bruinformula/mk11-DAQ-SMU/SMU V3/SMU.step

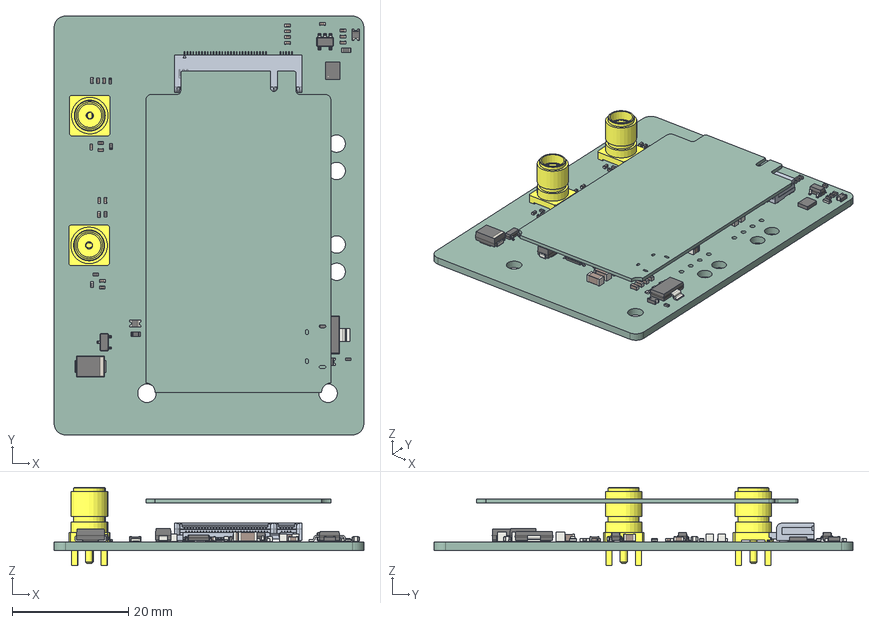
[picture p1: CAD file, 2026-05-11]
SMU V3/SMU.step
53.4 x 72.2 x 13.5 mm
SMA-J-P-H-ST-TH1 x 2
SOT-23-3
C_0402_1005Metric x 26
C_0805_2012Metric x 5
C_0603_1608Metric x 9
R_0603_1608Metric x 4
C_1206_3216Metric x 5
L_0402_1005Metric x 2
R_0402_1005Metric x 7
R_0805_2012Metric
D_0805_2012Metric x 5
D_SMA
SOT-23-5 x 3
c-1-2199119-5-c-3d
DU UC V1MINI - Krill_PCB
TI_SO-PowerPAD-8
D_SMB
LGA-14_3x2.5mm_P0.5mm_LayoutBorder3x4y
SOT-223
SMU V2_PCB
