bruinformula/mk11-DAQ-SMU/SPICE/power.asc

C1: cap; 0.01µ; V=10 Irms=0 Rser=0.0697 Lser=689p mfg="Würth Elektronik" pn="885012208008 WCAP-CSGP 1206" type="X7R"
C2: cap; 22µ; V=6.3 Irms=0 Rser=0.005 Lser=0 mfg="Murata" pn="GRM187R60J226ME15" type="X5R"
C3: cap; 22µ; V=6.3 Irms=0 Rser=0.005 Lser=0 mfg="Murata" pn="GRM187R60J226ME15" type="X5R"
C4: cap; 1.7p
D1: schottky; SS24
R1: res; 10k
R2: res; 3.3k
R3: res; {RLOAD}
R4: res; 180k
U1: TPS5430_TRANS
U2: CL31A107MQHNNN_Precise_DC0V_25degC_LT
U3: CL31A107MQHNNN_Precise_DC0V_25degC_LT
U4: CL31A107MQHNNN_Precise_DC0V_25degC_LT
U5: CL31A107MQHNNN_Precise_DC0V_25degC_LT
U6: CL31A107MQHNNN_Precise_DC0V_25degC_LT
U7: ETQP3M150KVN
V1: voltage; 12; Rser=.1
Named nets: 0, SW, Vsense, BOOT, VIN, VOUT, Vfb
.param RLOAD 200
.tran 0 30m 0 10u uic
.ac dec 10 1k 50Meg
.step dec param RLOAD 3 200 2
