bruinformula/mk11-DAQ-SMU/SMU V3/SMU V3.kicad_pcb

## KiCad design SMU V3/SMU V3.kicad_pcb (2026-05-11)

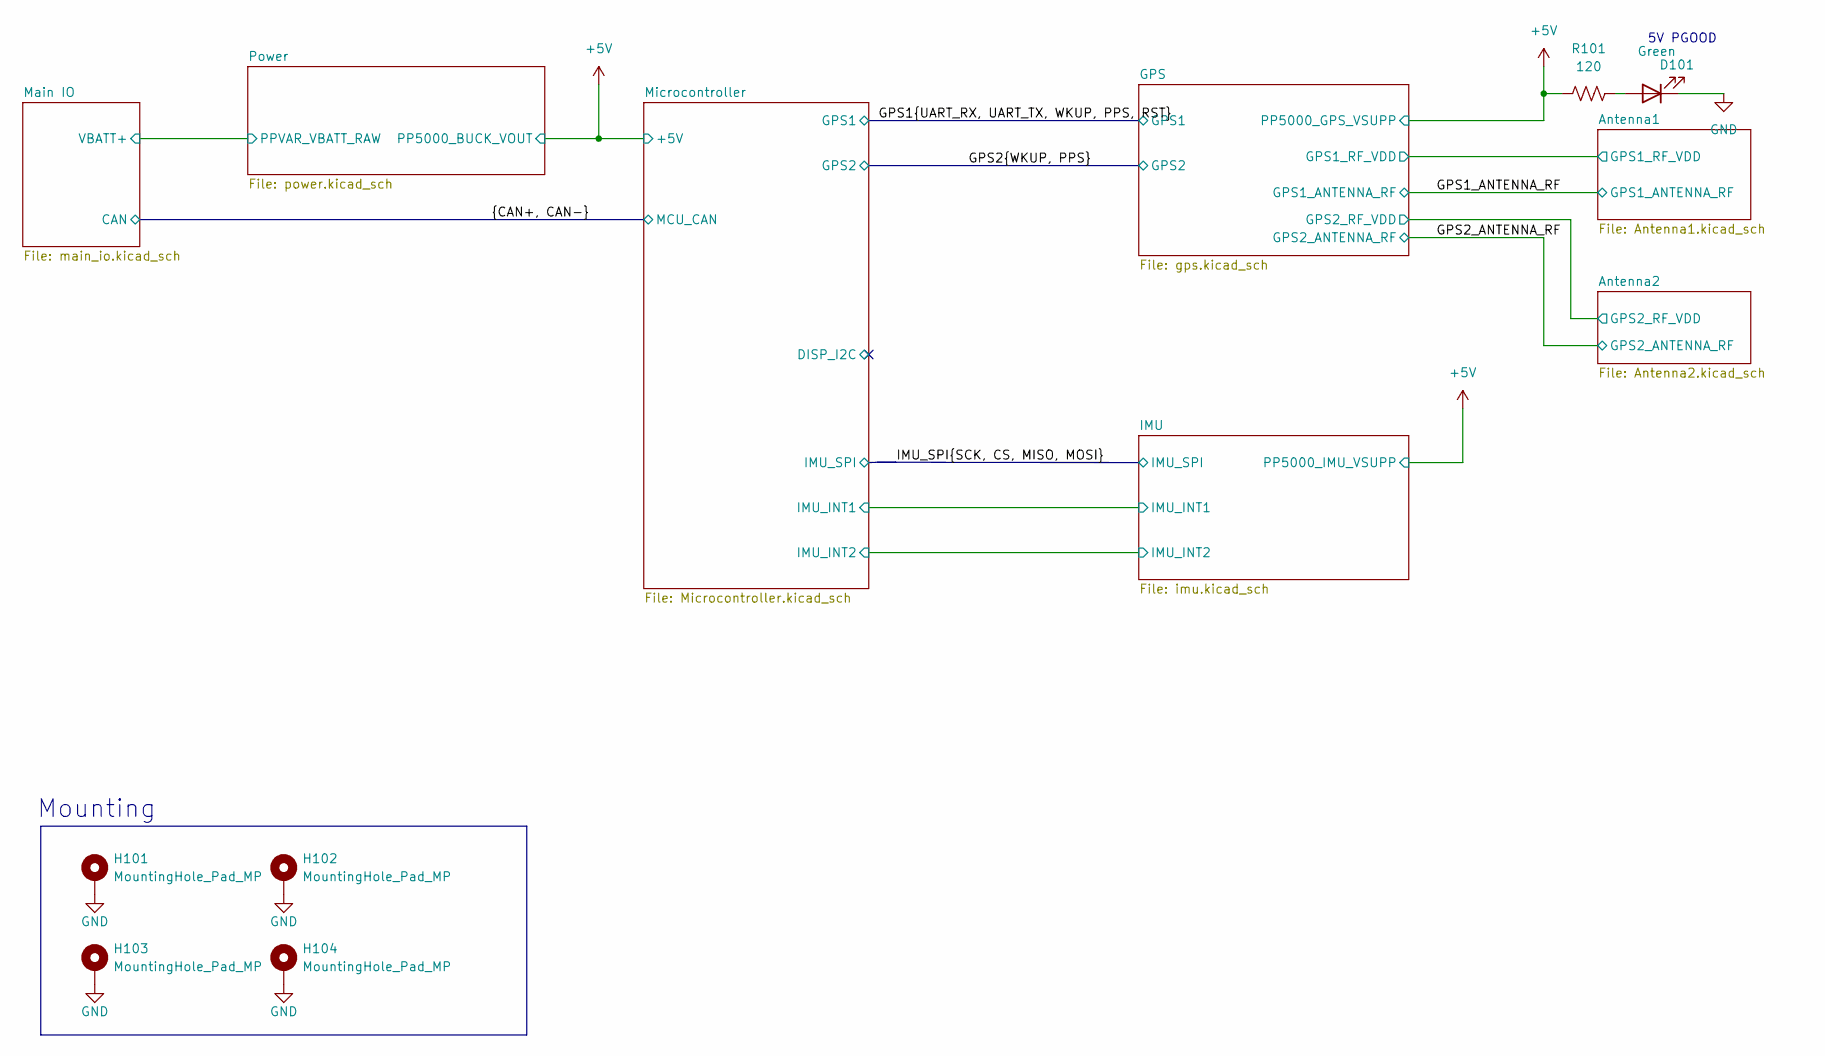
[picture p2: schematic SMU V3.kicad_sch]

Parts:
D101: Green; D_0805_2012Metric_Pad1.15x1.40mm_HandSolder; Mouser P/N 755-SMLMN2ECTT86C; Digikey P/N 846-SMLMN2ECTT86CCT-ND
H101, H102, H103, H104: MountingHole_Pad_MP; MountingHole_2.7mm_M2.5_Pad_Via; Mouser P/N N/A; Digikey P/N N/A
R101: 120; R_0603_1608Metric_Pad0.98x0.95mm_HandSolder; Mouser P/N 708-RMCF0603FT120R; Digikey P/N RMCF0603FT120RCT-ND

Connections:
+5V: R101.1; also elsewhere on the board
GND: D101.1 (K), H101.1 (1_1), H102.1 (1_1), H103.1 (1_1), H104.1 (1_1); also elsewhere on the board
unnamed: D101.2 (A), R101.2

Notes on the sheet:
5V PGOOD
Mounting

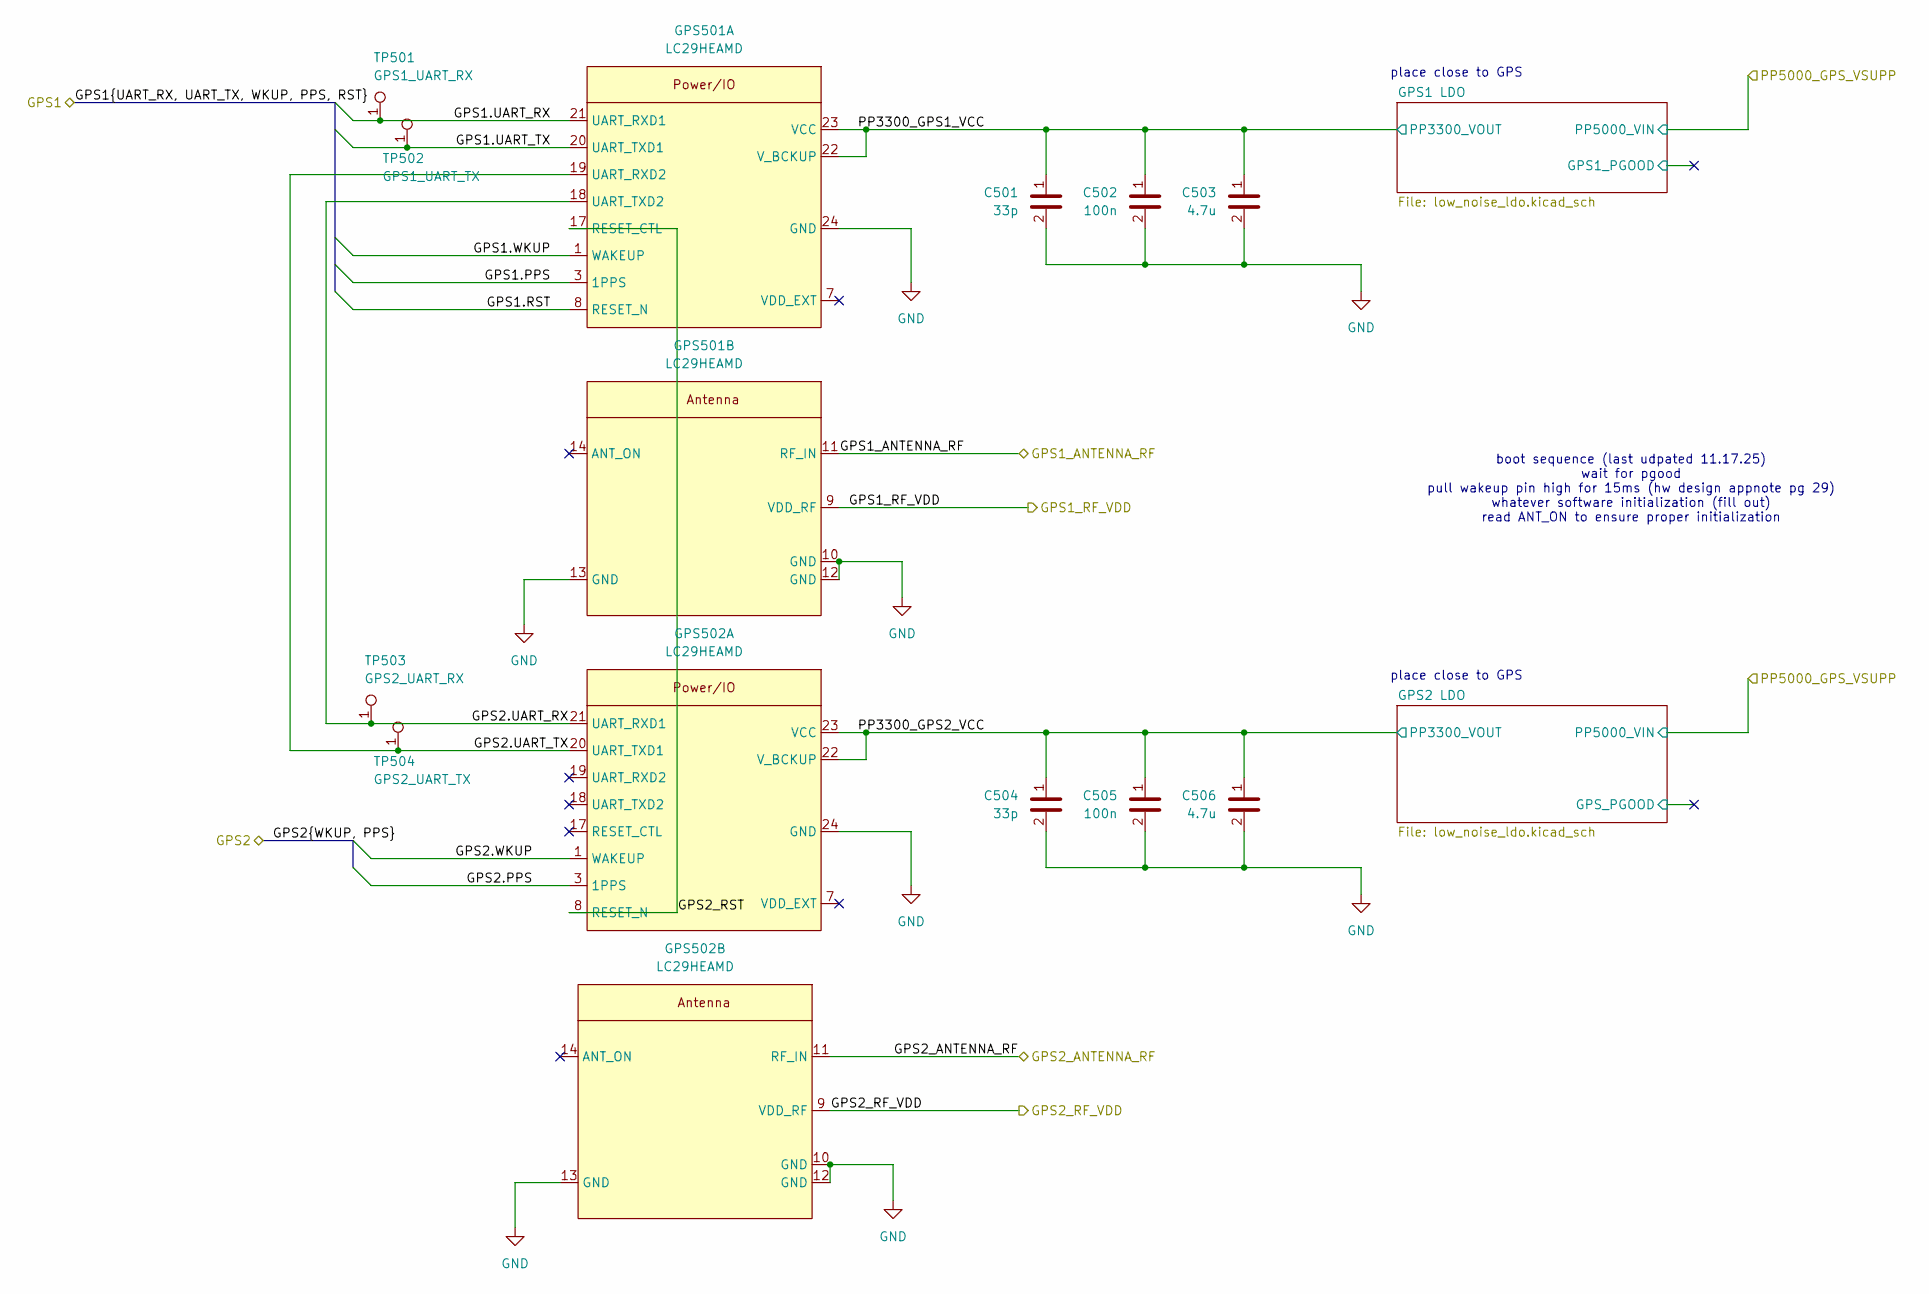
[picture p3: schematic gps.kicad_sch]

Parts:
C501, C504: 33p; C_0402_1005Metric_Pad0.74x0.62mm_HandSolder; LCSC P/N C1562
C502, C505: 100n; C_0402_1005Metric_Pad0.74x0.62mm_HandSolder; LCSC P/N C1525
C503, C506: 4.7u; C_0603_1608Metric_Pad1.08x0.95mm_HandSolder; LCSC P/N C19666
GPS501, GPS502: LC29HEAMD; Quectel LC49
TP501: GPS1_UART_RX; TestPoint_Keystone_5019_Miniature; Manufacturer P/N RH-5019; Digikey P/N 36-5019CT-ND
TP502: GPS1_UART_TX; TestPoint_Keystone_5019_Miniature; Manufacturer P/N RH-5019; Digikey P/N 36-5019CT-ND
TP503: GPS2_UART_RX; TestPoint_Keystone_5019_Miniature; Manufacturer P/N RH-5019; Digikey P/N 36-5019CT-ND
TP504: GPS2_UART_TX; TestPoint_Keystone_5019_Miniature; Manufacturer P/N RH-5019; Digikey P/N 36-5019CT-ND

Connections:
/Antenna1/GPS1_RF_VDD: GPS501.9 (VDD_RF); also elsewhere on the board
/Antenna2/GPS2_RF_VDD: GPS502.9 (VDD_RF); also elsewhere on the board
/GPS1.PPS: GPS501.3 (1PPS); also elsewhere on the board
/GPS1.RST: GPS501.8 (RESET_N); also elsewhere on the board
/GPS1.UART_RX: GPS501.21 (UART_RXD1), TP501.1; also elsewhere on the board
/GPS1.UART_TX: GPS501.20 (UART_TXD1), TP502.1; also elsewhere on the board
/GPS1.WKUP: GPS501.1 (WAKEUP); also elsewhere on the board
/GPS1_ANTENNA_RF: GPS501.11 (RF_IN); also elsewhere on the board
/GPS2.PPS: GPS502.3 (1PPS); also elsewhere on the board
/GPS2.WKUP: GPS502.1 (WAKEUP); also elsewhere on the board
/GPS2_ANTENNA_RF: GPS502.11 (RF_IN); also elsewhere on the board
/GPS/GPS2.UART_RX: GPS501.18 (UART_TXD2), GPS502.21 (UART_RXD1), TP503.1
/GPS/GPS2.UART_TX: GPS501.19 (UART_RXD2), GPS502.20 (UART_TXD1), TP504.1
/GPS/GPS2_RST: GPS501.17 (RESET_CTL), GPS502.8 (RESET_N)
/GPS/PP3300_GPS1_VCC: C501.1, C502.1, C503.1, GPS501.22 (V_BCKUP), GPS501.23 (VCC); also elsewhere on the board
/GPS/PP3300_GPS2_VCC: C504.1, C505.1, C506.1, GPS502.22 (V_BCKUP), GPS502.23 (VCC); also elsewhere on the board
GND: C501.2, C502.2, C503.2, C504.2, C505.2, C506.2, GPS501.10 (GND), GPS501.12 (GND), GPS501.13 (GND), GPS501.24 (GND), GPS502.10 (GND), GPS502.12 (GND), GPS502.13 (GND), GPS502.24 (GND); also elsewhere on the board

Notes on the sheet:
boot sequence (last udpated 11.17.25) wait for pgood pull wakeup pin high for 15ms (hw design appnote pg 29) whatever software initialization (fill out) read ANT_ON to ensure proper initialization
place close to GPS

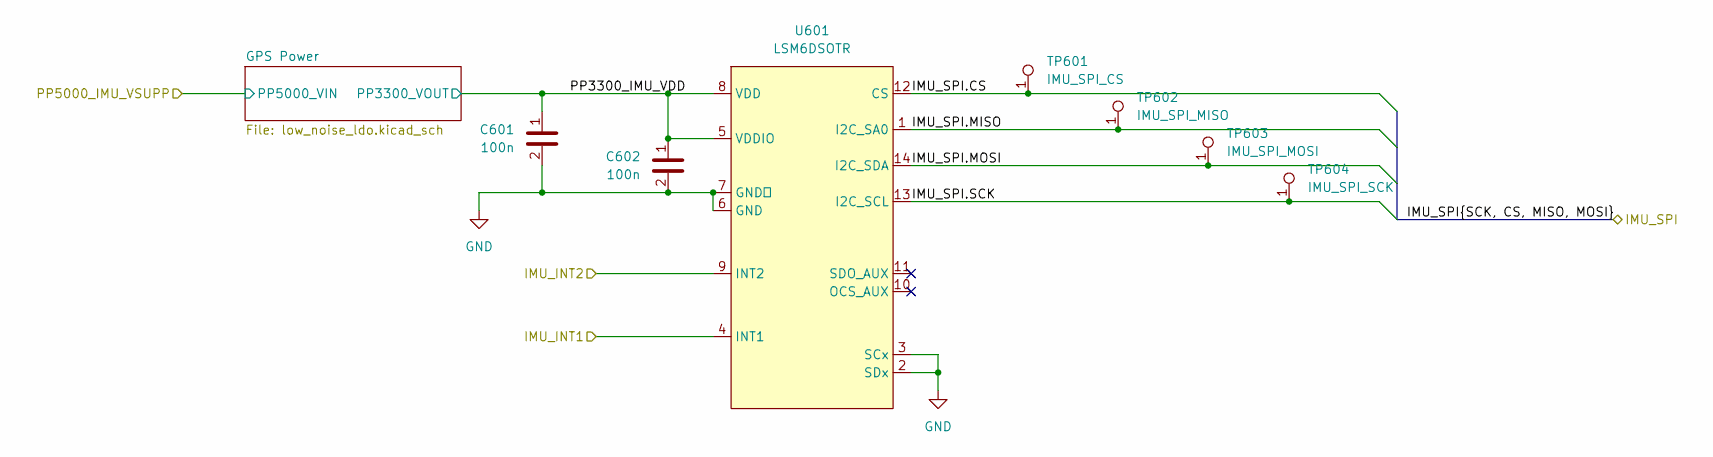
[picture p4: schematic imu.kicad_sch]

Parts:
C601, C602: 100n; C_0402_1005Metric_Pad0.74x0.62mm_HandSolder; LCSC P/N C1525
TP601: IMU_SPI_CS; TestPoint_Keystone_5019_Miniature; Manufacturer P/N RH-5019; Digikey P/N 36-5019CT-ND
TP602: IMU_SPI_MISO; TestPoint_Keystone_5019_Miniature; Manufacturer P/N RH-5019; Digikey P/N 36-5019CT-ND
TP603: IMU_SPI_MOSI; TestPoint_Keystone_5019_Miniature; Manufacturer P/N RH-5019; Digikey P/N 36-5019CT-ND
TP604: IMU_SPI_SCK; TestPoint_Keystone_5019_Miniature; Manufacturer P/N RH-5019; Digikey P/N 36-5019CT-ND
U601: LSM6DSOTR; LGA-14_3x2.5mm_P0.5mm_LayoutBorder3x4y; Manufacturer P/N LSM6DSOTR; Digikey P/N 497-18181-2-ND

Connections:
/IMU/IMU_INT1: U601.4 (INT1); also elsewhere on the board
/IMU/IMU_INT2: U601.9 (INT2); also elsewhere on the board
/IMU/PP3300_IMU_VDD: C601.1, C602.1, U601.5 (VDDIO), U601.8 (VDD); also elsewhere on the board
/IMU_SPI.CS: TP601.1, U601.12 (CS); also elsewhere on the board
/IMU_SPI.MISO: TP602.1, U601.1 (I2C_SA0); also elsewhere on the board
/IMU_SPI.MOSI: TP603.1, U601.14 (I2C_SDA); also elsewhere on the board
/IMU_SPI.SCK: TP604.1, U601.13 (I2C_SCL); also elsewhere on the board
GND: C601.2, C602.2, U601.2 (SDx), U601.3 (SCx), U601.6 (GND), U601.7 (GND); also elsewhere on the board

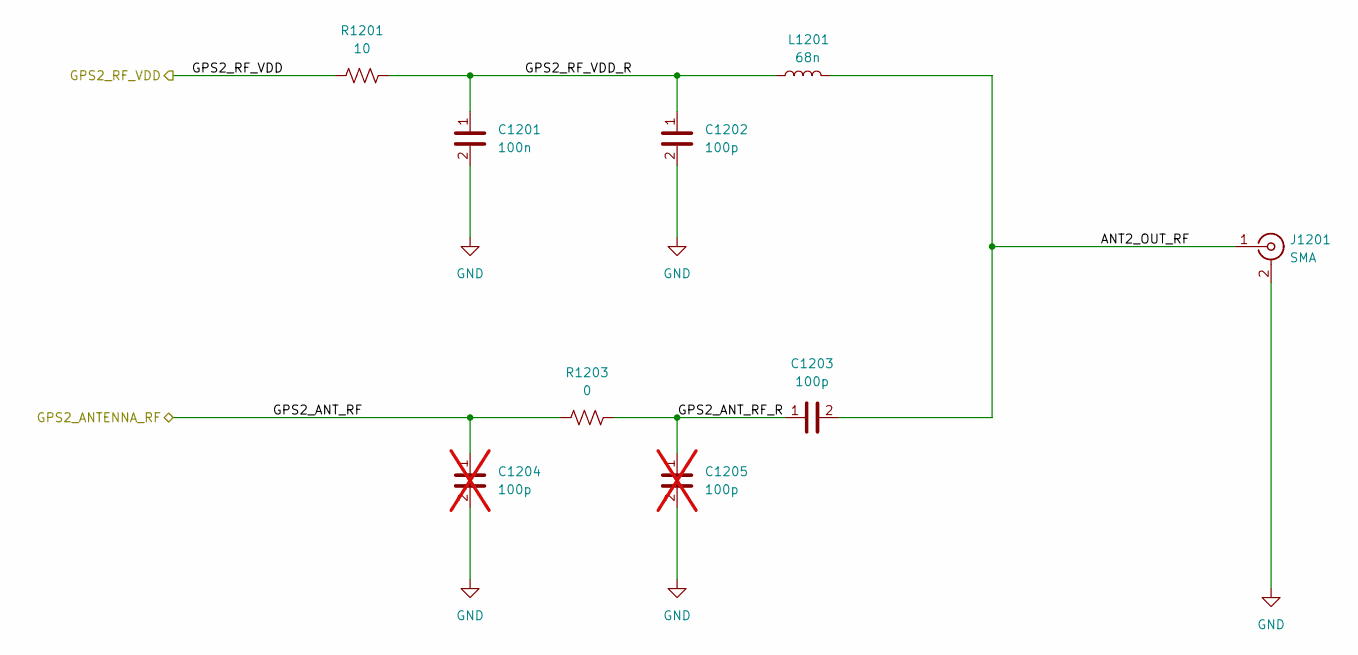
[picture p5: schematic Antenna2.kicad_sch]

Parts:
C1201: 100n; C_0402_1005Metric_Pad0.74x0.62mm_HandSolder; Manufacturer P/N CL05B104KB54PNC; LCSC P/N C307331
C1202, C1203: 100p; C_0402_1005Metric_Pad0.74x0.62mm_HandSolder; LCSC P/N C1546
C1204, C1205: 100p; C_0402_1005Metric_Pad0.74x0.62mm_HandSolder; LCSC P/N C1546; not fitted
J1201: SMA; THT SMA; Manufacturer P/N SMA-J-P-H-ST-TH1; Digikey P/N SAM8971-ND
L1201: 68n; L_0402_1005Metric_Pad0.77x0.64mm_HandSolder; Manufacturer P/N LQW15AN68NG0ZD; Digikey P/N 490-17700-2-ND
R1201: 10; R_0402_1005Metric_Pad0.72x0.64mm_HandSolder; Mouser P/N 708-RMCF0402FT10R0; Digikey P/N RMCF0402FT10R0CT-ND
R1203: 0; R_0402_1005Metric_Pad0.72x0.64mm_HandSolder; Mouser P/N 708-RMCF0402ZT0R00; Digikey P/N RMCF0402ZT0R00CT-ND

Connections:
/Antenna2/ANT2_OUT_RF: C1203.2, J1201.1, L1201.1
/Antenna2/GPS2_ANT_RF_R: C1203.1, C1205.1, R1203.2
/Antenna2/GPS2_RF_VDD: R1201.1; also elsewhere on the board
/Antenna2/GPS2_RF_VDD_R: C1201.1, C1202.1, L1201.2, R1201.2
/GPS2_ANTENNA_RF: C1204.1, R1203.1; also elsewhere on the board
GND: C1201.2, C1202.2, C1204.2, C1205.2, J1201.2; also elsewhere on the board

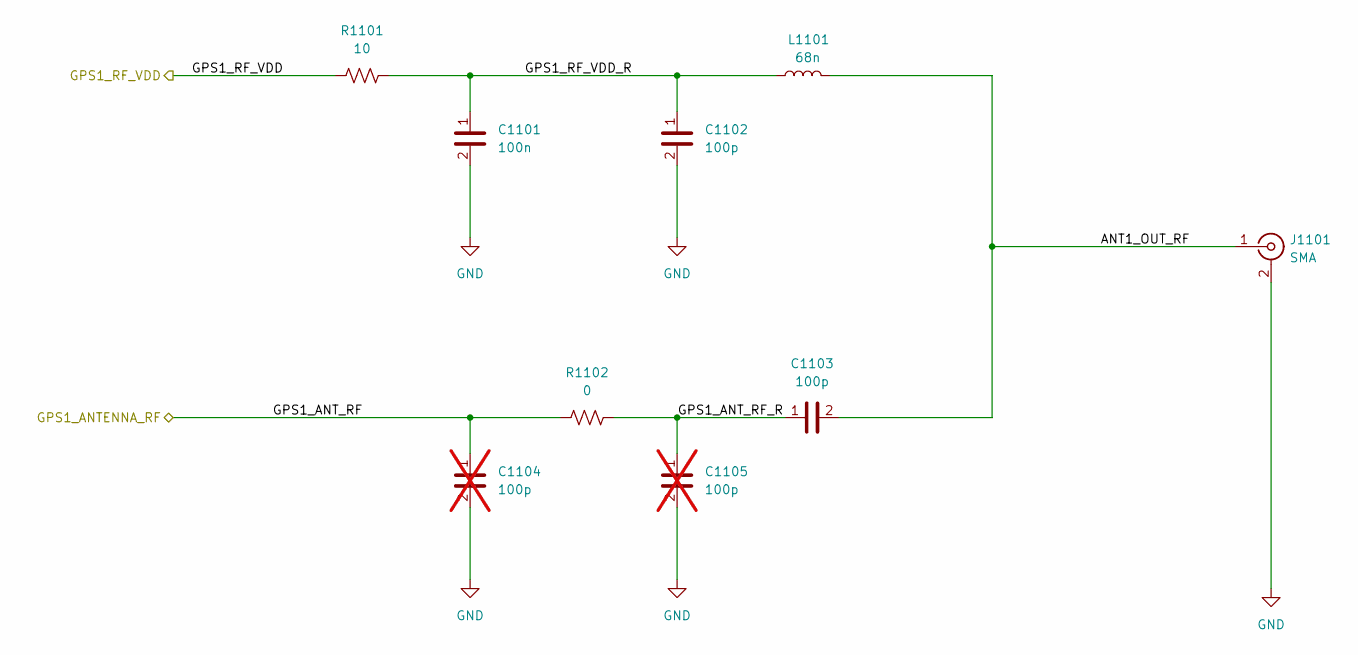
[picture p6: schematic Antenna1.kicad_sch]

Parts:
C1101: 100n; C_0402_1005Metric_Pad0.74x0.62mm_HandSolder; Manufacturer P/N CL05B104KB54PNC; LCSC P/N C307331
C1102, C1103: 100p; C_0402_1005Metric_Pad0.74x0.62mm_HandSolder; LCSC P/N C1546
C1104, C1105: 100p; C_0402_1005Metric_Pad0.74x0.62mm_HandSolder; LCSC P/N C1546; not fitted
J1101: SMA; THT SMA; Manufacturer P/N SMA-J-P-H-ST-TH1; Digikey P/N SAM8971-ND
L1101: 68n; L_0402_1005Metric_Pad0.77x0.64mm_HandSolder; Manufacturer P/N LQW15AN68NG0ZD; Digikey P/N 490-17700-2-ND
R1101: 10; R_0402_1005Metric_Pad0.72x0.64mm_HandSolder; Mouser P/N 708-RMCF0402FT10R0; Digikey P/N RMCF0402FT10R0CT-ND
R1102: 0; R_0402_1005Metric_Pad0.72x0.64mm_HandSolder; Mouser P/N 708-RMCF0402ZT0R00; Digikey P/N RMCF0402ZT0R00CT-ND

Connections:
/Antenna1/ANT1_OUT_RF: C1103.2, J1101.1, L1101.1
/Antenna1/GPS1_ANT_RF_R: C1103.1, C1105.1, R1102.2
/Antenna1/GPS1_RF_VDD: R1101.1; also elsewhere on the board
/Antenna1/GPS1_RF_VDD_R: C1101.1, C1102.1, L1101.2, R1101.2
/GPS1_ANTENNA_RF: C1104.1, R1102.1; also elsewhere on the board
GND: C1101.2, C1102.2, C1104.2, C1105.2, J1101.2; also elsewhere on the board

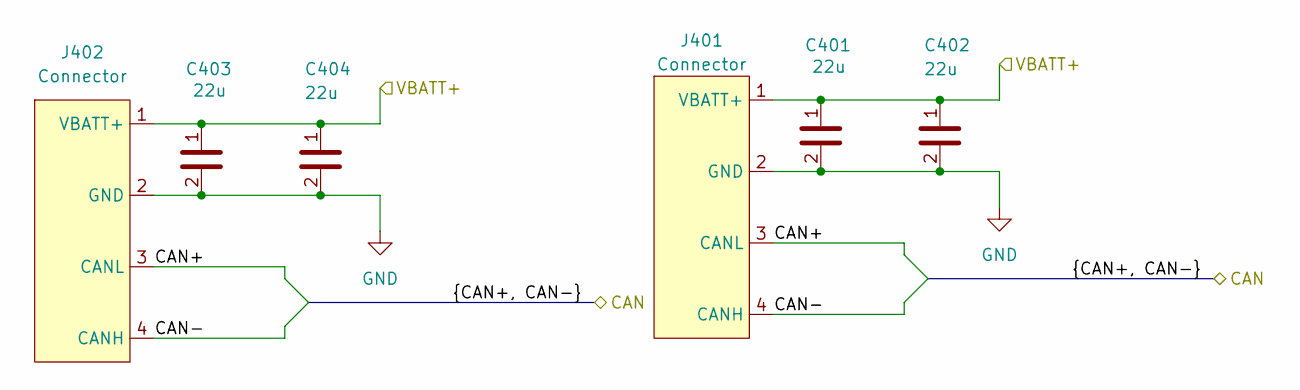
[picture p7: schematic main_io.kicad_sch]

Parts:
C401, C402, C403, C404: 22u; C_0805_2012Metric_Pad1.18x1.45mm_HandSolder; Mouser P/N 187-CL21A226MAYNNNE
J401, J402: Connector; Molex_Micro-Fit_3.0_43650-0400_1x04_P3.00mm_Horizontal; Manufacturer P/N 0436500401; Digikey P/N WM1867-ND

Connections:
/CAN+: J401.3 (CANL), J402.3 (CANL); also elsewhere on the board
/CAN-: J401.4 (CANH), J402.4 (CANH); also elsewhere on the board
/Main IO/VBATT+: C401.1, C402.1, C403.1, C404.1, J401.1 (VBATT+), J402.1 (VBATT+); also elsewhere on the board
GND: C401.2, C402.2, C403.2, C404.2, J401.2 (GND), J402.2 (GND); also elsewhere on the board

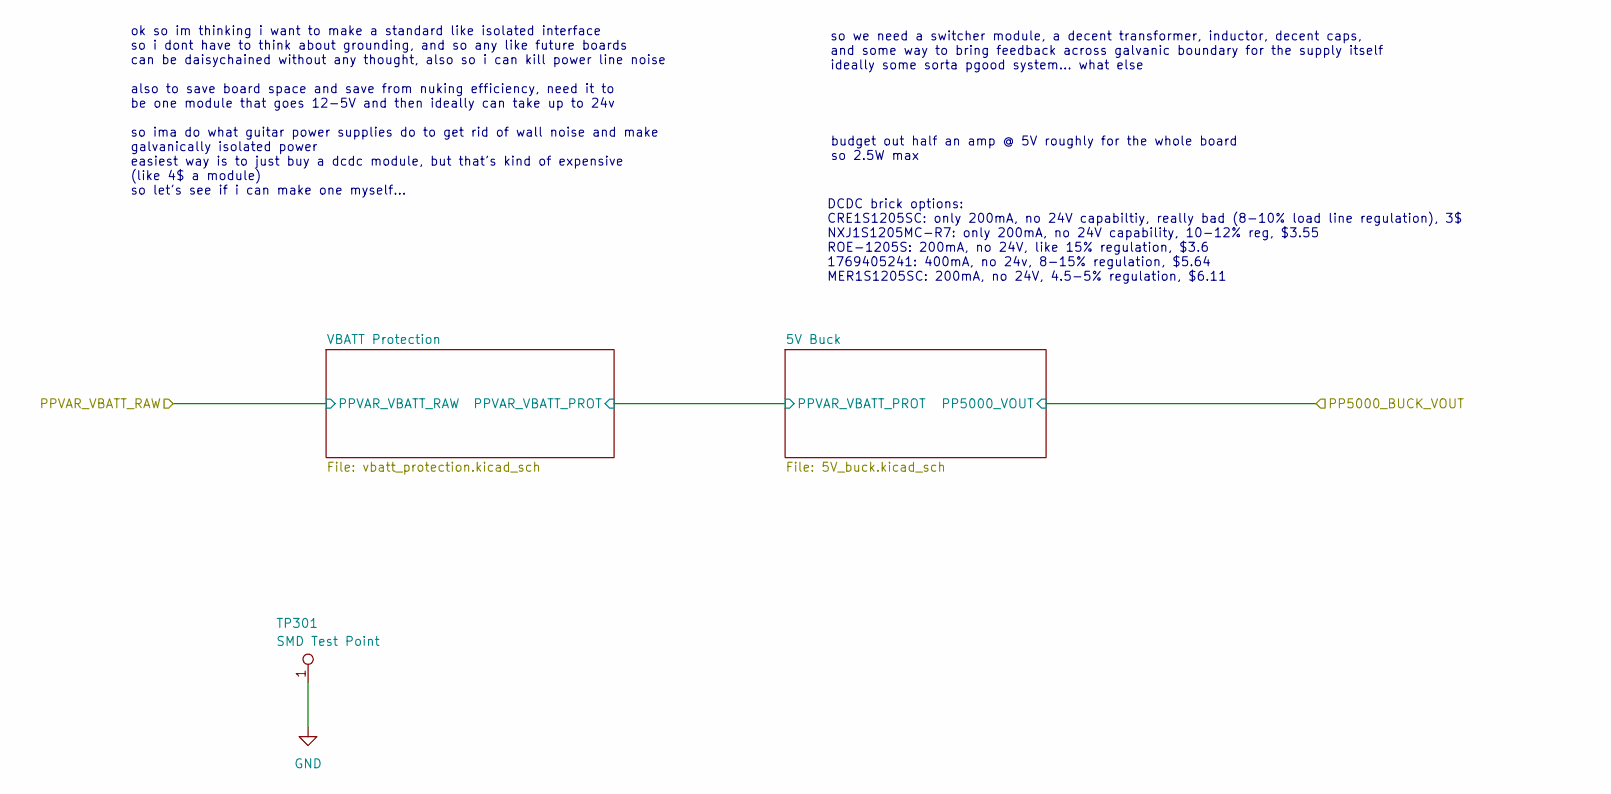
[picture p8: schematic power.kicad_sch]

Parts:
TP301: SMD Test Point; TestPoint_Keystone_5019_Miniature; Manufacturer P/N RH-5019; Digikey P/N 36-5019CT-ND

Connections:
GND: TP301.1; also elsewhere on the board

Notes on the sheet:
ok so im thinking i want to make a standard like isolated interface so i dont have to think about grounding, and so any like future boards can be daisychained without any thought, also so i can kill power line noise also to save board space and save from nuking efficiency, need it to be one module 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
so we need a switcher module, a decent transformer, inductor, decent caps, and some way to bring feedback across galvanic boundary for the supply itself ideally some sorta pgood system... what else
DCDC brick options: CRE1S1205SC: only 200mA, no 24V capabiltiy, really bad (8-10% load line regulation), 3$ NXJ1S1205MC-R7: only 200mA, no 24V capability, 10-12% reg, $3.55 ROE-1205S: 200mA, no 24V, like 15% regulation, $3.6 1769405241: 400mA, no 24v, 8-15% regulation, $5.64 MER1S1205SC: 200mA, no 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
budget out half an amp @ 5V roughly for the whole board so 2.5W max

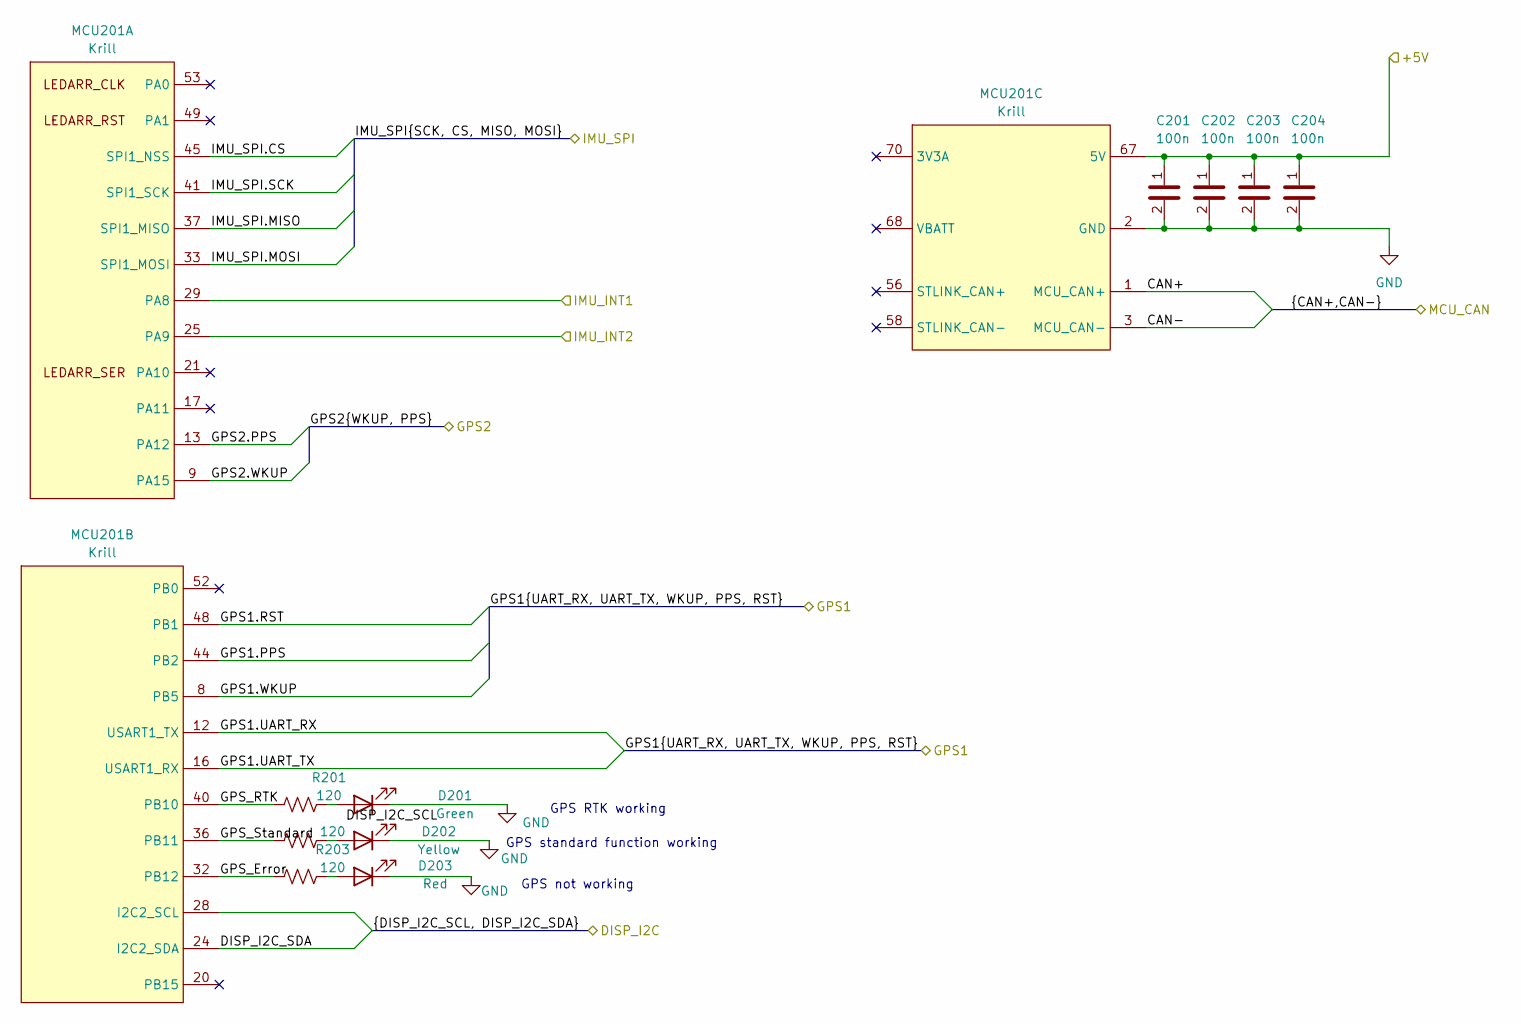
[picture p9: schematic Microcontroller.kicad_sch]

Parts:
C201, C202, C203, C204: 100n; C_0402_1005Metric_Pad0.74x0.62mm_HandSolder; LCSC P/N C1525
D201: Green; D_0805_2012Metric_Pad1.15x1.40mm_HandSolder; Mouser P/N 755-SMLMN2ECTT86C; Digikey P/N 846-SMLMN2ECTT86CCT-ND
D202: Yellow; D_0805_2012Metric_Pad1.15x1.40mm_HandSolder; Mouser P/N 645-599-0140-007F; Digikey P/N 350-4356-1-ND
D203: Red; D_0603_1608Metric_Pad1.05x0.95mm_HandSolder; Mouser P/N 720-LRQ976.01; Digikey P/N 475-LRQ976.01-P2R2-1CT-ND
MCU201: Krill; Manufacturer P/N 2E0BC21-S85BM-7H; Digikey P/N 609-MDT850M01501CT-ND
R201, R202, R203: 120; R_0603_1608Metric_Pad0.98x0.95mm_HandSolder; Mouser P/N 708-RMCF0603FT120R; Digikey P/N RMCF0603FT120RCT-ND

Connections:
+5V: C201.1, C202.1, C203.1, C204.1, MCU201.67 (5V), MCU201.69 (5V), MCU201.71 (5V); also elsewhere on the board
/CAN+: MCU201.1 (MCU_CAN+); also elsewhere on the board
/CAN-: MCU201.3 (MCU_CAN-); also elsewhere on the board
/GPS1.PPS: MCU201.44 (PB2); also elsewhere on the board
/GPS1.RST: MCU201.48 (PB1); also elsewhere on the board
/GPS1.UART_RX: MCU201.12 (USART1_TX); also elsewhere on the board
/GPS1.UART_TX: MCU201.16 (USART1_RX); also elsewhere on the board
/GPS1.WKUP: MCU201.8 (PB5); also elsewhere on the board
/GPS2.PPS: MCU201.13 (PA12); also elsewhere on the board
/GPS2.WKUP: MCU201.9 (PA15); also elsewhere on the board
/IMU/IMU_INT1: MCU201.29 (PA8); also elsewhere on the board
/IMU/IMU_INT2: MCU201.25 (PA9); also elsewhere on the board
/IMU_SPI.CS: MCU201.45 (SPI1_NSS); also elsewhere on the board
/IMU_SPI.MISO: MCU201.37 (SPI1_MISO); also elsewhere on the board
/IMU_SPI.MOSI: MCU201.33 (SPI1_MOSI); also elsewhere on the board
/IMU_SPI.SCK: MCU201.41 (SPI1_SCK); also elsewhere on the board
/Microcontroller/DISP_I2C_SDA: MCU201.24 (I2C2_SDA)
/Microcontroller/GPS_Error: MCU201.32 (PB12), R203.1
/Microcontroller/GPS_RTK: MCU201.40 (PB10), R201.1
/Microcontroller/GPS_Standard: MCU201.36 (PB11), R202.1
GND: C201.2, C202.2, C203.2, C204.2, D201.1 (K), D202.1 (K), D203.1 (K), MCU201.2 (GND), MCU201.4 (GND), MCU201.5 (GND), MCU201.6 (GND), MCU201.7 (GND), MCU201.10 (GND), MCU201.11 (GND), MCU201.14 (GND), MCU201.15 (GND), MCU201.18 (GND), MCU201.19 (GND), MCU201.22 (GND), MCU201.23 (GND), MCU201.26 (GND), MCU201.27 (GND), MCU201.30 (GND), MCU201.31 (GND), MCU201.34 (GND), MCU201.35 (GND), MCU201.38 (GND), MCU201.39 (GND), MCU201.42 (GND), MCU201.43 (GND), MCU201.46 (GND), MCU201.47 (GND), MCU201.50 (GND), MCU201.51 (GND), MCU201.54 (GND), MCU201.55 (GND), MCU201.57 (GND), MCU201.73 (GND), MCU201.75 (GND); also elsewhere on the board
unnamed: D201.2 (A), R201.2
unnamed: D202.2 (A), R202.2
unnamed: D203.2 (A), R203.2

Notes on the sheet:
GPS standard function working
GPS not working
GPS RTK working

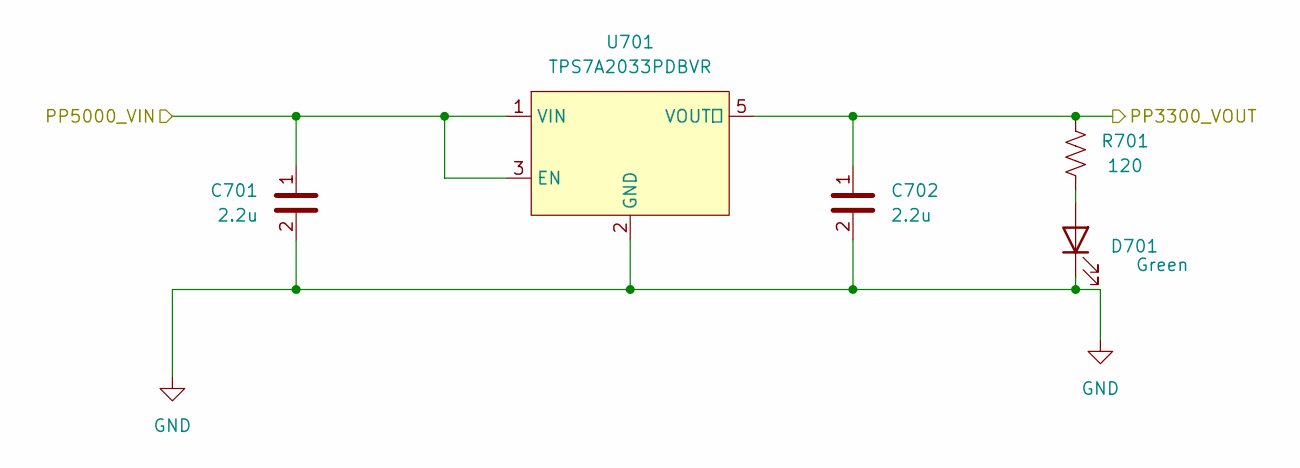
[picture p10: schematic low_noise_ldo.kicad_sch]

Parts:
C701, C702: 2.2u; C_0402_1005Metric_Pad0.74x0.62mm_HandSolder; LCSC P/N C12530
D701: Green; D_0805_2012Metric_Pad1.15x1.40mm_HandSolder; Mouser P/N 755-SMLMN2ECTT86C; Digikey P/N 846-SMLMN2ECTT86CCT-ND
R701: 120; R_0603_1608Metric_Pad0.98x0.95mm_HandSolder; Mouser P/N 708-RMCF0603FT120R; Digikey P/N RMCF0603FT120RCT-ND
U701: TPS7A2033PDBVR; SOT-23-5_HandSoldering; Manufacturer P/N TPS7A2033PDBVR; Digikey P/N 296-TPS7A2033PDBVRCT-ND

Connections:
+5V: C701.1, U701.1 (VIN), U701.3 (EN); also elsewhere on the board
/GPS/PP3300_GPS1_VCC: C702.1, R701.1, U701.5 (VOUT); also elsewhere on the board
GND: C701.2, C702.2, D701.1 (K), U701.2 (GND); also elsewhere on the board
unnamed: D701.2 (A), R701.2

Parts of its further copies:
C801, C802, C901, C902: 2.2u; C_0402_1005Metric_Pad0.74x0.62mm_HandSolder; LCSC P/N C12530
D801, D901: Green; D_0805_2012Metric_Pad1.15x1.40mm_HandSolder; Mouser P/N 755-SMLMN2ECTT86C; Digikey P/N 846-SMLMN2ECTT86CCT-ND
R801, R901: 120; R_0603_1608Metric_Pad0.98x0.95mm_HandSolder; Mouser P/N 708-RMCF0603FT120R; Digikey P/N RMCF0603FT120RCT-ND
U801, U901: TPS7A2033PDBVR; SOT-23-5_HandSoldering; Manufacturer P/N TPS7A2033PDBVR; Digikey P/N 296-TPS7A2033PDBVRCT-ND

Connections of its further copies:
+5V: C801.1, C901.1, U801.1 (VIN), U801.3 (EN), U901.1 (VIN), U901.3 (EN); also elsewhere on the board
/GPS/PP3300_GPS2_VCC: C802.1, R801.1, U801.5 (VOUT); also elsewhere on the board
/IMU/PP3300_IMU_VDD: C902.1, R901.1, U901.5 (VOUT); also elsewhere on the board
GND: C801.2, C802.2, C901.2, C902.2, D801.1 (K), D901.1 (K), U801.2 (GND), U901.2 (GND); also elsewhere on the board
unnamed: D801.2 (A), R801.2
unnamed: D901.2 (A), R901.2

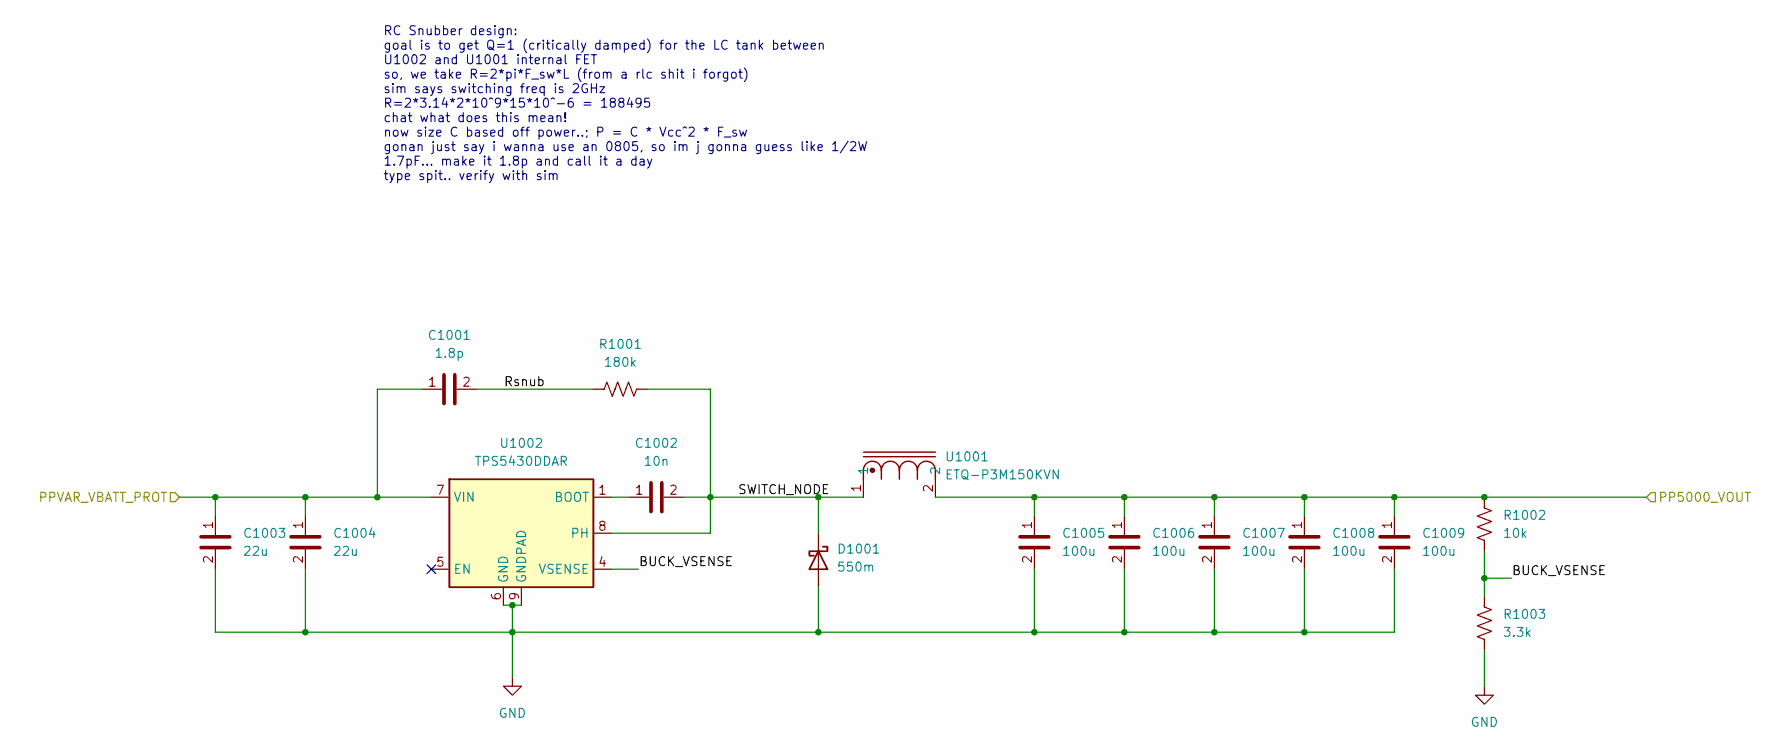
[picture p11: schematic 5V_buck.kicad_sch]

Parts:
C1001: 1.8p; C_0805_2012Metric_Pad1.18x1.45mm_HandSolder; Mouser P/N 581-600F1R8BT; Digikey P/N 1284-1034-1-ND
C1002: 10n; C_0603_1608Metric_Pad1.08x0.95mm_HandSolder; Mouser P/N 77-VJ0603Y103KXAAC; Digikey P/N 720-1376-1-ND
C1003, C1004: 22u; C_0603_1608Metric_Pad1.08x0.95mm_HandSolder; LCSC P/N C59461
C1005, C1006, C1007, C1008, C1009: 100u; C_1206_3216Metric_Pad1.33x1.80mm_HandSolder; LCSC P/N C15008
D1001: 550m; D_SMA_Handsoldering; Mouser P/N 750-SS54-HF; LCSC P/N C22452
R1001: 180k; R_0805_2012Metric_Pad1.20x1.40mm_HandSolder; Mouser P/N 708-RMCF0805FT180K; Digikey P/N RMCF0805FT180KCT-ND
R1002: 10k; R_0402_1005Metric_Pad0.72x0.64mm_HandSolder; Mouser P/N 708-RMCF0402FT10K0; Digikey P/N RMCF0402FT10K0CT-ND
R1003: 3.3k; R_0402_1005Metric_Pad0.72x0.64mm_HandSolder; Mouser P/N 708-RMCF0402FT3K30; Digikey P/N RMCF0402FT3K30CT-ND
U1001: ETQ-P3M150KVN; BWVS005050404R7M00; Manufacturer P/N ETQ-P3M150KVN; Digikey P/N P19763CT-ND
U1002: TPS5430DDAR; TI_SO-PowerPAD-8; Mouser P/N 595-TPS5430DDAR; Digikey P/N 296-26988-1-ND

Connections:
+5V: C1005.1, C1006.1, C1007.1, C1008.1, C1009.1, R1002.2, U1001.2; also elsewhere on the board
/Power/5V Buck/BUCK_VSENSE: R1002.1, R1003.2, U1002.4 (VSENSE)
/Power/5V Buck/PPVAR_VBATT_PROT: C1001.1, C1003.1, C1004.1, U1002.7 (VIN); also elsewhere on the board
/Power/5V Buck/Rsnub: C1001.2, R1001.1
/Power/5V Buck/SWITCH_NODE: C1002.2, D1001.1 (K), R1001.2, U1001.1, U1002.8 (PH)
GND: C1003.2, C1004.2, C1005.2, C1006.2, C1007.2, C1008.2, C1009.2, D1001.2 (A), R1003.1, U1002.6 (GND), U1002.9 (GNDPAD); also elsewhere on the board
unnamed: C1002.1, U1002.1 (BOOT)

Notes on the sheet:
RC Snubber design: goal is to get Q=1 (critically damped) for the LC tank between U1002 and U1001 internal FET so, we take R=2*pi*F_sw*L (from a rlc shit i forgot) sim says switching freq is 2GHz R=2*3.14*2*10^9*15*10^-6 = 188495 chat what does this mean! now size C based off power..; P = C * Vcc^2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

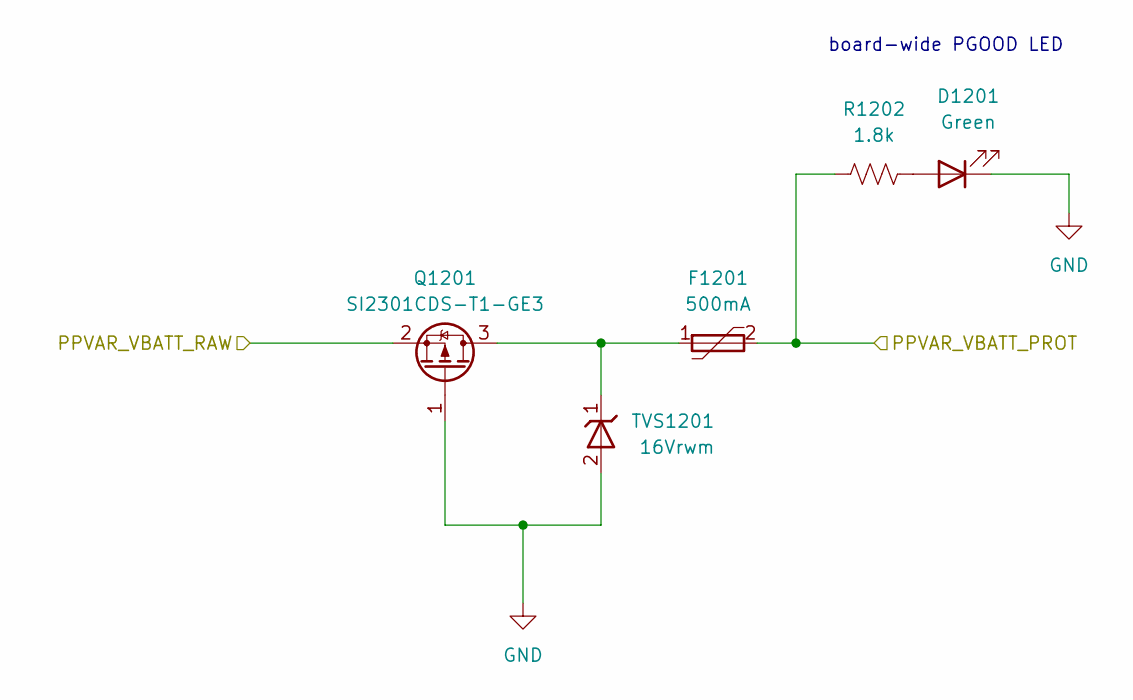
[picture p12: schematic vbatt_protection.kicad_sch]

Parts:
D1201: Green; D_0805_2012Metric_Pad1.15x1.40mm_HandSolder; Mouser P/N 755-SMLMN2ECTT86C; Digikey P/N 846-SMLMN2ECTT86CCT-ND
F1201: 500mA; Fuse_1812_4532Metric; Manufacturer P/N 0ZCG0050AF2C; Digikey P/N 5923-0ZCG0050AF2CCT-ND
Q1201: SI2301CDS-T1-GE3; SOT-23-3; Mouser P/N 781-SI2301CDS-T1-GE3; LCSC P/N C10487
R1202: 1.8k; R_0603_1608Metric_Pad0.98x0.95mm_HandSolder; Mouser P/N 708-RMCF0603FT1K80; Digikey P/N RMCF0603FT1K80CT-ND
TVS1201: 16Vrwm; D_SMA-SMB_Universal_Handsoldering; Manufacturer P/N SMBJ16A; Digikey P/N SMBJ16ABCT-ND

Connections:
/Main IO/VBATT+: Q1201.2 (S); also elsewhere on the board
/Power/5V Buck/PPVAR_VBATT_PROT: F1201.2, R1202.1; also elsewhere on the board
GND: D1201.1 (K), Q1201.1 (G), TVS1201.2; also elsewhere on the board
unnamed: D1201.2 (A), R1202.2
unnamed: F1201.1, Q1201.3 (D), TVS1201.1

Notes on the sheet:
board-wide PGOOD LED
