bruinformula/mk11-DAQ-SMU/SMU V3/SMU V3.kicad_pcb

## KiCad design SMU V3/SMU V3.kicad_pcb (continued)

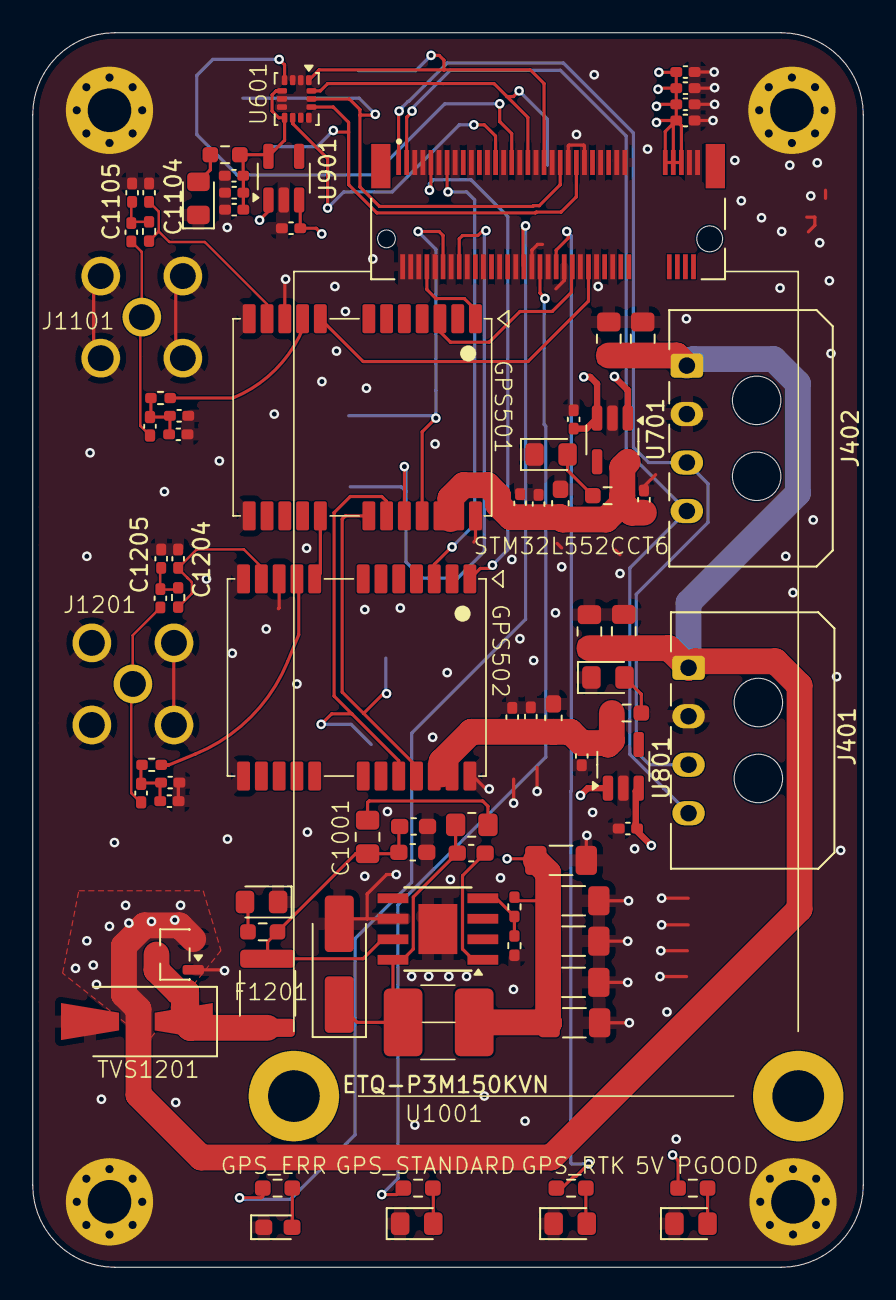
[picture p13: board SMU V3.kicad_pcb from above]

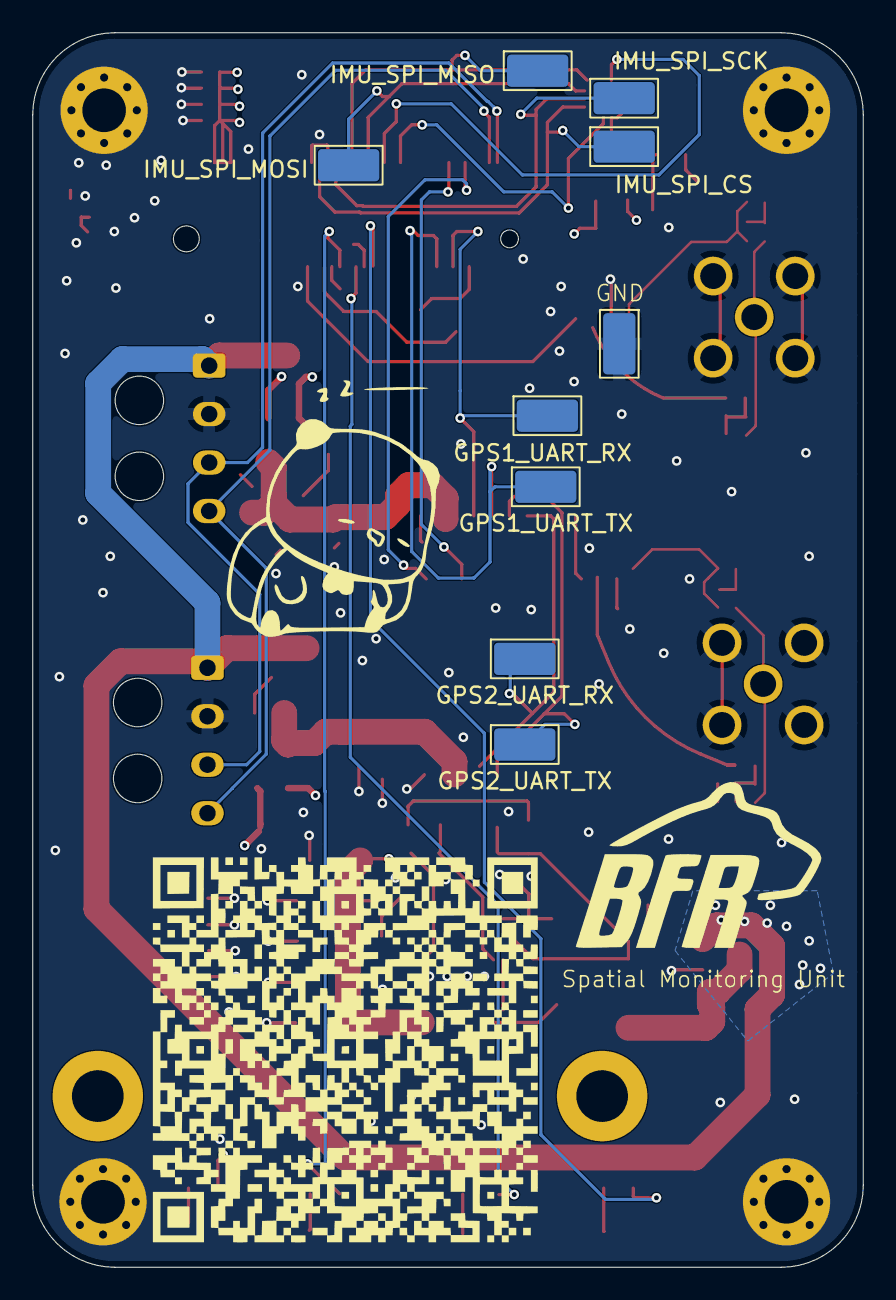
[picture p14: board SMU V3.kicad_pcb from below]

Board: 4 copper layers, 51.4 x 76.4 mm, 96 parts (9 on the bottom side), 51 nets.
