bruinformula/mk11-DAQ-SMU/SMU V1/SMU V1 (tony.wang@bruinracing.org).kicad_pcb

## KiCad design SMU V1/SMU V1 (tony.wang@bruinracing.org).kicad_pcb (2026-01-21, an earlier design)

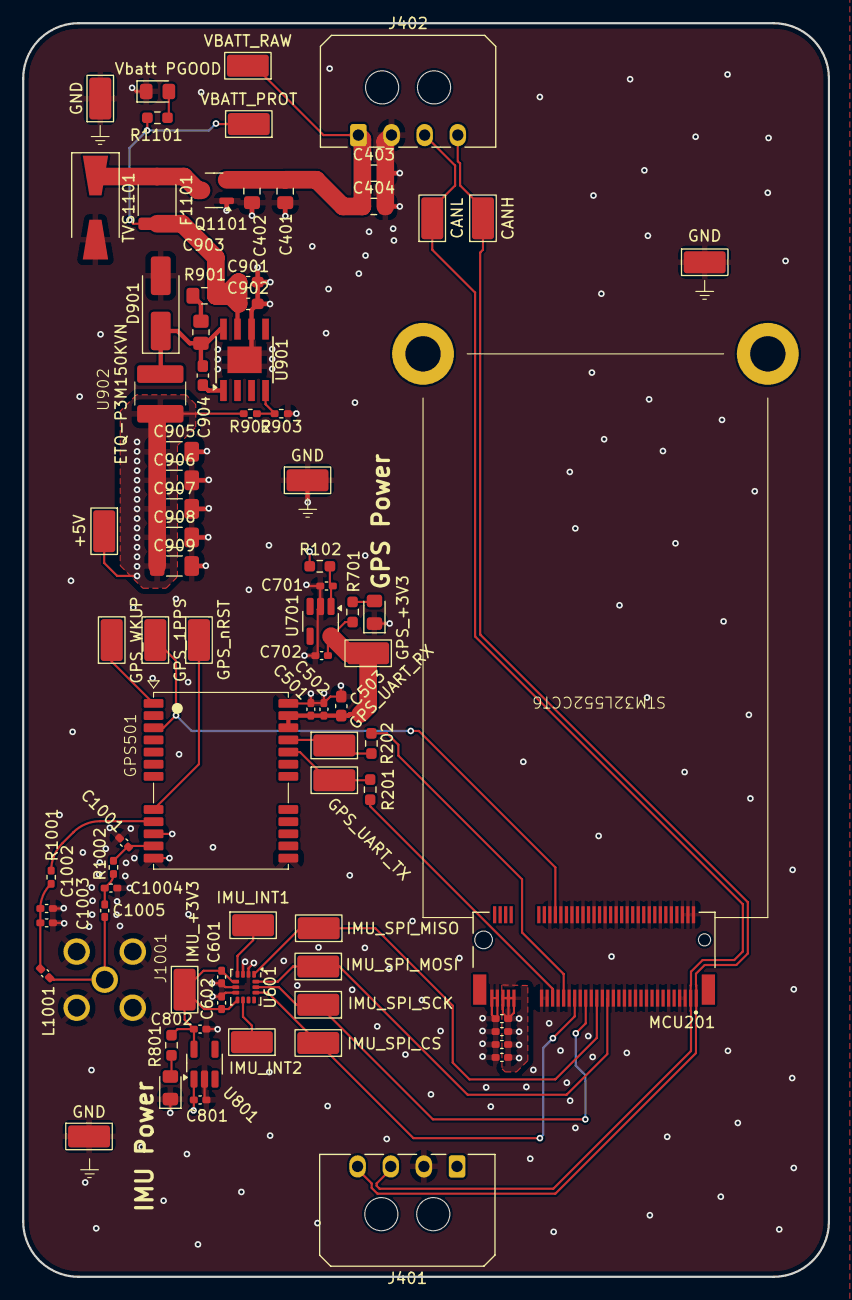
[picture p15: board SMU V1 (tony.wang@bruinracing.org).kicad_pcb from above]

Board: 4 copper layers, 72.9 x 113.5 mm, 82 parts (0 on the bottom side), 35 nets.

Parts:
C201, C202, C203, C204, C502, C601, C602, C1002: 100n; C_0402_1005Metric_Pad0.74x0.62mm_HandSolder
C401, C402, C403, C404: 22u; C_0805_2012Metric_Pad1.18x1.45mm_HandSolder
C501: 33p; C_0402_1005Metric_Pad0.74x0.62mm_HandSolder
C503: 4.7u; C_0603_1608Metric_Pad1.08x0.95mm_HandSolder
C701, C702, C801, C802: 2.2u; C_0402_1005Metric_Pad0.74x0.62mm_HandSolder
C901, C902: 22u; C_0603_1608Metric_Pad1.08x0.95mm_HandSolder
C903: 1.8p; C_0805_2012Metric_Pad1.18x1.45mm_HandSolder
C904: 10n; C_0603_1608Metric_Pad1.08x0.95mm_HandSolder
C905, C906, C907, C908, C909: 100u; C_1206_3216Metric_Pad1.33x1.80mm_HandSolder
C1001, C1003, C1004, C1005: 100p; C_0402_1005Metric_Pad0.74x0.62mm_HandSolder
D701, D801: GPS Power; D_0805_2012Metric_Pad1.15x1.40mm_HandSolder
D901: 550m; D_SMA_Handsoldering
D1101: Vbatt PGOOD; D_0805_2012Metric_Pad1.15x1.40mm_HandSolder
F1101: 500mA; Fuse_1812_4532Metric
GPS501: LC29HEAMD; Quectel LC49
J401, J402: Connector; Molex_Micro-Fit_3.0_43650-0400_1x04_P3.00mm_Horizontal
J1001: SMA; THT SMA
L1001: 68n; L_0402_1005Metric_Pad0.77x0.64mm_HandSolder
MCU201: Krill; TE_1-2199119-5
Q1101: SI2301CDS-T1-GE3; SOT-23-3
R102, R201, R202: 0; R_0603_1608Metric_Pad0.98x0.95mm_HandSolder
R701, R801: 120; R_0603_1608Metric_Pad0.98x0.95mm_HandSolder
R901: 180k; R_0805_2012Metric_Pad1.20x1.40mm_HandSolder
R902: 10k; R_0402_1005Metric_Pad0.72x0.64mm_HandSolder
R903: 3.3k; R_0402_1005Metric_Pad0.72x0.64mm_HandSolder
R1001: 10; R_0402_1005Metric_Pad0.72x0.64mm_HandSolder
R1002: 0; R_0402_1005Metric_Pad0.72x0.64mm_HandSolder
R1101: 1.8k; R_0603_1608Metric_Pad0.98x0.95mm_HandSolder
TP205: CANH; TestPoint_Keystone_5019_Miniature
TP206: CANL; TestPoint_Keystone_5019_Miniature
TP301: VBATT_RAW; TestPoint_Keystone_5019_Miniature
TP302: VBATT_PROT; TestPoint_Keystone_5019_Miniature
TP303: +5V; TestPoint_Keystone_5019_Miniature
TP305, TP306, TP307, TP308: GND; TestPoint_Keystone_5019_Miniature
TP501: GPS_UART_RX; TestPoint_Keystone_5019_Miniature
TP502: GPS_UART_TX; TestPoint_Keystone_5019_Miniature
TP503: GPS_WKUP; TestPoint_Keystone_5019_Miniature
TP504: GPS_1PPS; TestPoint_Keystone_5019_Miniature
TP505: GPS_nRST; TestPoint_Keystone_5019_Miniature
TP506: GPS_+3V3; TestPoint_Keystone_5019_Miniature
TP601: IMU_+3V3; TestPoint_Keystone_5019_Miniature
TP602: IMU_INT2; TestPoint_Keystone_5019_Miniature
TP603: IMU_INT1; TestPoint_Keystone_5019_Miniature
TP604: IMU_SPI_CS; TestPoint_Keystone_5019_Miniature
TP605: IMU_SPI_MISO; TestPoint_Keystone_5019_Miniature
TP606: IMU_SPI_MOSI; TestPoint_Keystone_5019_Miniature
TP607: IMU_SPI_SCK; TestPoint_Keystone_5019_Miniature
TVS1101: 16Vrwm; D_SMA-SMB_Universal_Handsoldering
U601: LSM6DSOTR; LGA-14_3x2.5mm_P0.5mm_LayoutBorder3x4y
U701, U801: TPS7A2033PDBVR; SOT-23-5_HandSoldering
U901: TPS5430DDAR; TI_SO-PowerPAD-8
U902: ETQ-P3M150KVN; BWVS005050404R7M00

Connections:
+5V: C201.1, C202.1, C203.1, C204.1, C801.1, C905.1, C906.1, C907.1, C908.1, C909.1, MCU201.67 (5V), MCU201.69 (5V), MCU201.71 (5V), R102.2, R902.2, TP303.1, U801.1 (VIN), U902.2
/Antenna/ANT_OUT_RF: C1005.2, J1001.1, L1001.1
/Antenna/GPS_ANT_RF: C1001.1, GPS501.11 (RF_IN), R1002.1
/Antenna/GPS_ANT_RF_R: C1004.1, C1005.1, R1002.2
/Antenna/GPS_RF_VDD: GPS501.9 (VDD_RF), R1001.1
/Antenna/GPS_RF_VDD_R: C1002.1, C1003.1, L1001.2, R1001.2
/CAN+: J401.4 (CANH), J402.4 (CANH), MCU201.1 (MCU_CAN+), TP205.1
/CAN-: J401.3 (CANL), J402.3 (CANL), MCU201.3 (MCU_CAN-), TP206.1
/GPS/GPS_1PPS: GPS501.3 (1PPS), MCU201.52 (PB0), TP504.1
/GPS/GPS_UART.RX: GPS501.21 (UART_RXD), R202.2, TP501.1
/GPS/GPS_UART.TX: GPS501.20 (UART_TXD), R201.2, TP502.1
/GPS/GPS_WKUP: GPS501.1 (WAKEUP), TP503.1
/GPS/GPS_nRST: GPS501.8 (RESET_N), TP505.1
/GPS/PP3300_GPS_VCC: C501.1, C502.1, C503.1, C702.1, GPS501.22 (V_BCKUP), GPS501.23 (VCC), R701.1, TP506.1, U701.5 (VOUT)
/GPS/PP5000_GPS_VSUPP: C701.1, R102.1, U701.1 (VIN)
/IMU/IMU_INT1: TP603.1, U601.4 (INT1)
/IMU/IMU_INT2: TP602.1, U601.9 (INT2)
/IMU/PP3300_IMU_VDD: C601.1, C602.1, C802.1, R801.1, TP601.1, U601.5 (VDDIO), U601.8 (VDD), U801.5 (VOUT)
/IMU_SPI.CS: MCU201.45 (SPI1_NSS), TP604.1, U601.12 (CS)
/IMU_SPI.MISO: MCU201.37 (SPI1_MISO), TP605.1, U601.1 (SPI_MISO)
/IMU_SPI.MOSI: MCU201.33 (SPI1_MOSI), TP606.1, U601.14 (4W_SPI_MOSI)
/IMU_SPI.SCK: MCU201.41 (SPI1_SCK), TP607.1, U601.13 (SPI_SCK)
/Main IO/VBATT+: C401.1, C402.1, C403.1, C404.1, J401.1 (VBATT+), J402.1 (VBATT+), Q1101.2 (S), TP301.1
/Power/5V Buck/BUCK_VSENSE: R902.1, R903.2, U901.4 (VSENSE)
/Power/5V Buck/PPVAR_VBATT_PROT: C901.1, C902.1, C903.1, F1101.2, R1101.1, TP302.1, U901.7 (VIN)
/Power/5V Buck/Rsnub: C903.2, R901.1
/Power/5V Buck/SWITCH_NODE: C904.2, D901.1 (K), R901.2, U901.8 (PH), U902.1
GND: C201.2, C202.2, C203.2, C204.2, C401.2, C402.2, C403.2, C404.2, C501.2, C502.2, C503.2, C601.2, C602.2, C701.2, C702.2, C801.2, C802.2, C901.2, C902.2, C905.2, C906.2, C907.2, C908.2, C909.2, C1001.2, C1002.2, C1003.2, C1004.2, D701.1 (K), D801.1 (K), D901.2 (A), D1101.1 (K), GPS501.10 (GND), GPS501.12 (GND), GPS501.13 (GND), GPS501.24 (GND), J401.2 (GND), J402.2 (GND), J1001.2, MCU201.2 (GND), MCU201.4 (GND), MCU201.5 (GND), MCU201.6 (GND), MCU201.7 (GND), MCU201.10 (GND), MCU201.11 (GND), MCU201.14 (GND), MCU201.15 (GND), MCU201.18 (GND), MCU201.19 (GND), MCU201.22 (GND), MCU201.23 (GND), MCU201.26 (GND), MCU201.27 (GND), MCU201.30 (GND), MCU201.31 (GND), MCU201.34 (GND), MCU201.35 (GND), MCU201.38 (GND), MCU201.39 (GND), MCU201.42 (GND), MCU201.43 (GND), MCU201.46 (GND), MCU201.47 (GND), MCU201.50 (GND), MCU201.51 (GND), MCU201.54 (GND), MCU201.55 (GND), MCU201.57 (GND), MCU201.73 (GND), MCU201.75 (GND), Q1101.1 (G), R903.1, TP305.1, TP306.1, TP307.1, TP308.1, TVS1101.2, U601.2 (SDx), U601.3 (SCx), U601.6 (GND), U601.7 (GND), U701.2 (GND), U801.2 (GND), U901.6 (GND), U901.9 (GNDPAD)
unnamed: D701.2 (A), R701.2
unnamed: D801.2 (A), R801.2
unnamed: D1101.2 (A), R1101.2
unnamed: MCU201.53 (UART4_TX), R201.1
unnamed: MCU201.49 (UART4_RX), R202.1
unnamed: F1101.1, Q1101.3 (D), TVS1101.1
unnamed: C904.1, U901.1 (BOOT)
