bruinformula/mk11-DAQ-SMU/SMU V2/SMU V2.kicad_pcb

## KiCad design SMU V2/SMU V2.kicad_pcb (2026-04-22, an earlier design)

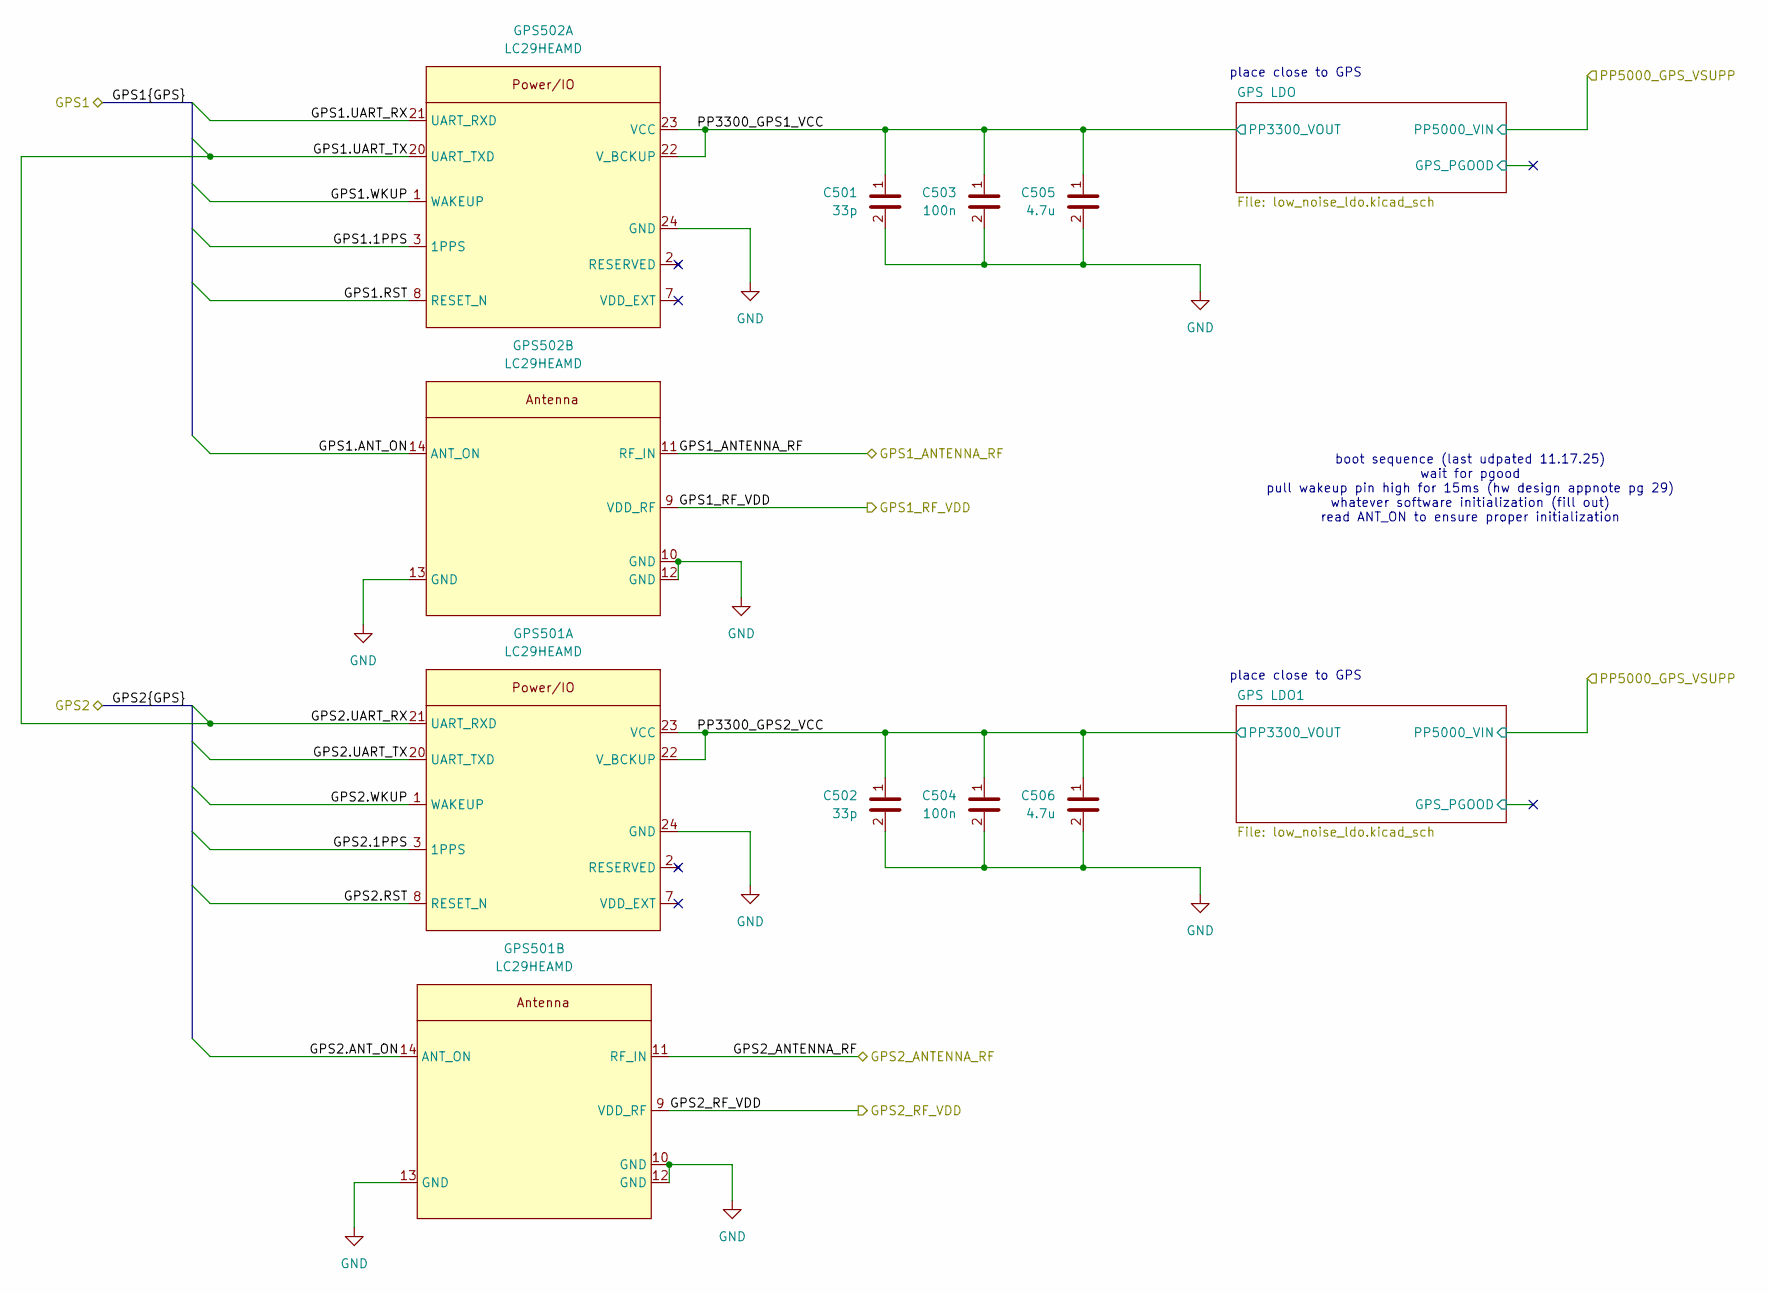
[picture p16: schematic gps.kicad_sch]

Parts:
C501, C502: 33p; C_0402_1005Metric_Pad0.74x0.62mm_HandSolder; LCSC P/N C1562
C503, C504: 100n; C_0402_1005Metric_Pad0.74x0.62mm_HandSolder; LCSC P/N C1525
C505, C506: 4.7u; C_0603_1608Metric_Pad1.08x0.95mm_HandSolder; LCSC P/N C19666
GPS501, GPS502: LC29HEAMD; Quectel LC49

Connections:
/Antenna1/GPS1_RF_VDD: GPS502.9 (VDD_RF); also elsewhere on the board
/Antenna2/GPS2_RF_VDD: GPS501.9 (VDD_RF); also elsewhere on the board
/GPS1.1PPS: GPS502.3 (1PPS); also elsewhere on the board
/GPS1.ANT_ON: GPS502.14 (ANT_ON); also elsewhere on the board
/GPS1.RST: GPS502.8 (RESET_N); also elsewhere on the board
/GPS1.UART_RX: GPS502.21 (UART_RXD); also elsewhere on the board
/GPS1.WKUP: GPS502.1 (WAKEUP); also elsewhere on the board
/GPS1_ANTENNA_RF: GPS502.11 (RF_IN); also elsewhere on the board
/GPS2.1PPS: GPS501.3 (1PPS); also elsewhere on the board
/GPS2.ANT_ON: GPS501.14 (ANT_ON); also elsewhere on the board
/GPS2.RST: GPS501.8 (RESET_N); also elsewhere on the board
/GPS2.UART_RX: GPS501.21 (UART_RXD), GPS502.20 (UART_TXD); also elsewhere on the board
/GPS2.UART_TX: GPS501.20 (UART_TXD); also elsewhere on the board
/GPS2.WKUP: GPS501.1 (WAKEUP); also elsewhere on the board
/GPS2_ANTENNA_RF: GPS501.11 (RF_IN); also elsewhere on the board
/GPS/PP3300_GPS1_VCC: C501.1, C503.1, C505.1, GPS502.22 (V_BCKUP), GPS502.23 (VCC); also elsewhere on the board
/GPS/PP3300_GPS2_VCC: C502.1, C504.1, C506.1, GPS501.22 (V_BCKUP), GPS501.23 (VCC); also elsewhere on the board
GND: C501.2, C502.2, C503.2, C504.2, C505.2, C506.2, GPS501.10 (GND), GPS501.12 (GND), GPS501.13 (GND), GPS501.24 (GND), GPS502.10 (GND), GPS502.12 (GND), GPS502.13 (GND), GPS502.24 (GND); also elsewhere on the board

Notes on the sheet:
boot sequence (last udpated 11.17.25) wait for pgood pull wakeup pin high for 15ms (hw design appnote pg 29) whatever software initialization (fill out) read ANT_ON to ensure proper initialization
place close to GPS

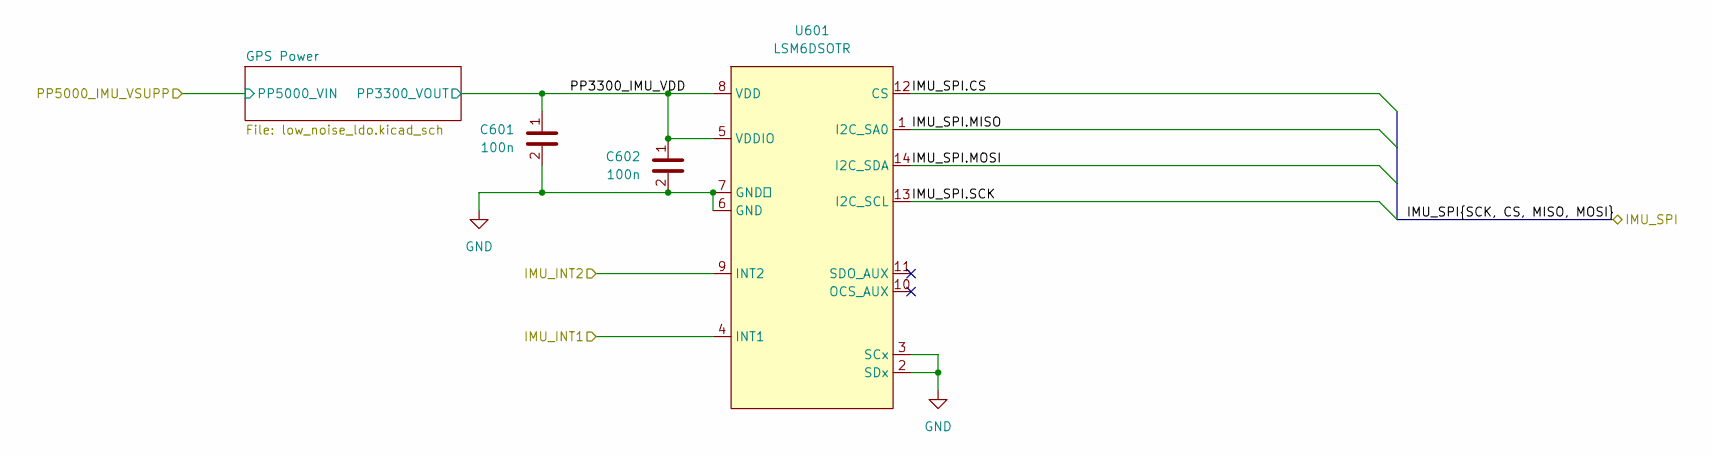
[picture p17: schematic imu.kicad_sch]

Parts:
C601, C602: 100n; C_0402_1005Metric_Pad0.74x0.62mm_HandSolder; LCSC P/N C1525
U601: LSM6DSOTR; LGA-14_3x2.5mm_P0.5mm_LayoutBorder3x4y; Manufacturer P/N LSM6DSOTR; Digikey P/N 497-18181-2-ND

Connections:
/IMU/IMU_INT1: U601.4 (INT1); also elsewhere on the board
/IMU/IMU_INT2: U601.9 (INT2); also elsewhere on the board
/IMU/PP3300_IMU_VDD: C601.1, C602.1, U601.5 (VDDIO), U601.8 (VDD); also elsewhere on the board
/IMU_SPI.CS: U601.12 (CS); also elsewhere on the board
/IMU_SPI.MISO: U601.1 (I2C_SA0); also elsewhere on the board
/IMU_SPI.MOSI: U601.14 (I2C_SDA); also elsewhere on the board
/IMU_SPI.SCK: U601.13 (I2C_SCL); also elsewhere on the board
GND: C601.2, C602.2, U601.2 (SDx), U601.3 (SCx), U601.6 (GND), U601.7 (GND); also elsewhere on the board

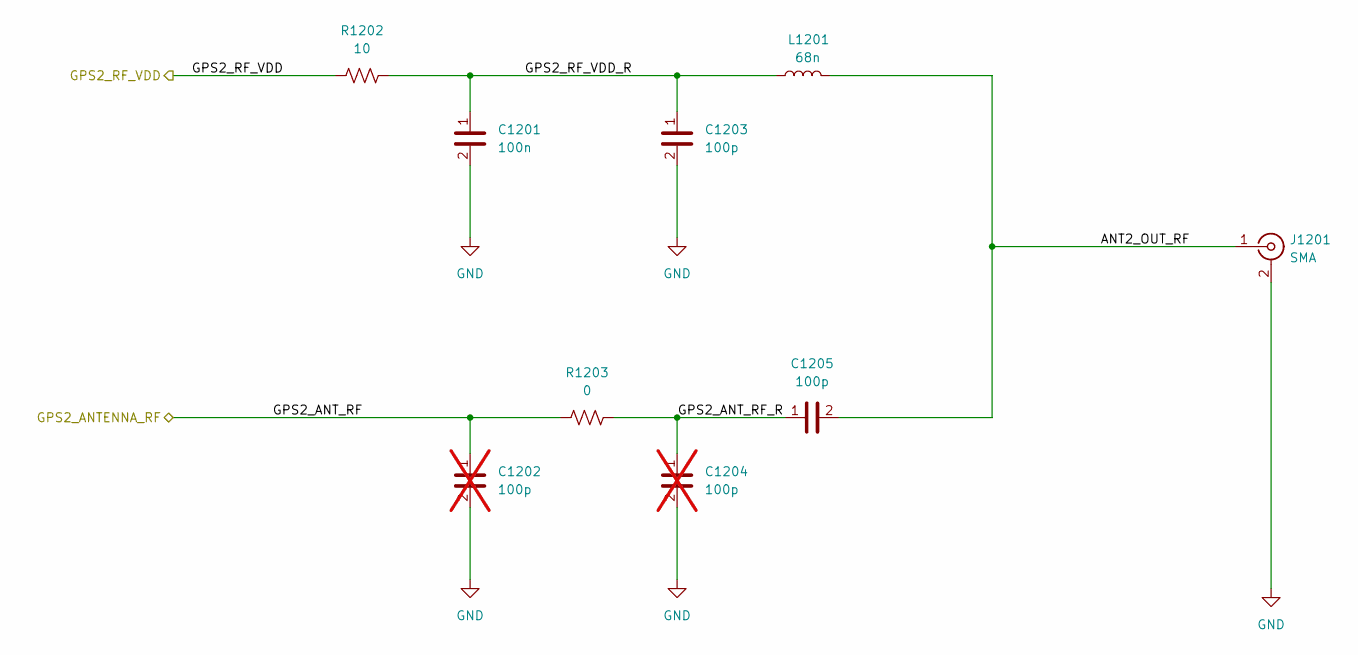
[picture p18: schematic Antenna2.kicad_sch]

Parts:
C1201: 100n; C_0402_1005Metric_Pad0.74x0.62mm_HandSolder; Manufacturer P/N CL05B104KB54PNC; LCSC P/N C307331
C1202, C1204: 100p; C_0402_1005Metric_Pad0.74x0.62mm_HandSolder; LCSC P/N C1546; not fitted
C1203, C1205: 100p; C_0402_1005Metric_Pad0.74x0.62mm_HandSolder; LCSC P/N C1546
J1201: SMA; THT SMA; Manufacturer P/N SMA-J-P-H-ST-TH1; Digikey P/N SAM8971-ND
L1201: 68n; L_0402_1005Metric_Pad0.77x0.64mm_HandSolder; Manufacturer P/N LQW15AN68NG0ZD; Digikey P/N 490-17700-2-ND
R1202: 10; R_0402_1005Metric_Pad0.72x0.64mm_HandSolder; Mouser P/N 708-RMCF0402FT10R0; Digikey P/N RMCF0402FT10R0CT-ND
R1203: 0; R_0402_1005Metric_Pad0.72x0.64mm_HandSolder; Mouser P/N 708-RMCF0402ZT0R00; Digikey P/N RMCF0402ZT0R00CT-ND

Connections:
/Antenna2/ANT2_OUT_RF: C1205.2, J1201.1, L1201.1
/Antenna2/GPS2_ANT_RF_R: C1204.1, C1205.1, R1203.2
/Antenna2/GPS2_RF_VDD: R1202.1; also elsewhere on the board
/Antenna2/GPS2_RF_VDD_R: C1201.1, C1203.1, L1201.2, R1202.2
/GPS2_ANTENNA_RF: C1202.1, R1203.1; also elsewhere on the board
GND: C1201.2, C1202.2, C1203.2, C1204.2, J1201.2; also elsewhere on the board

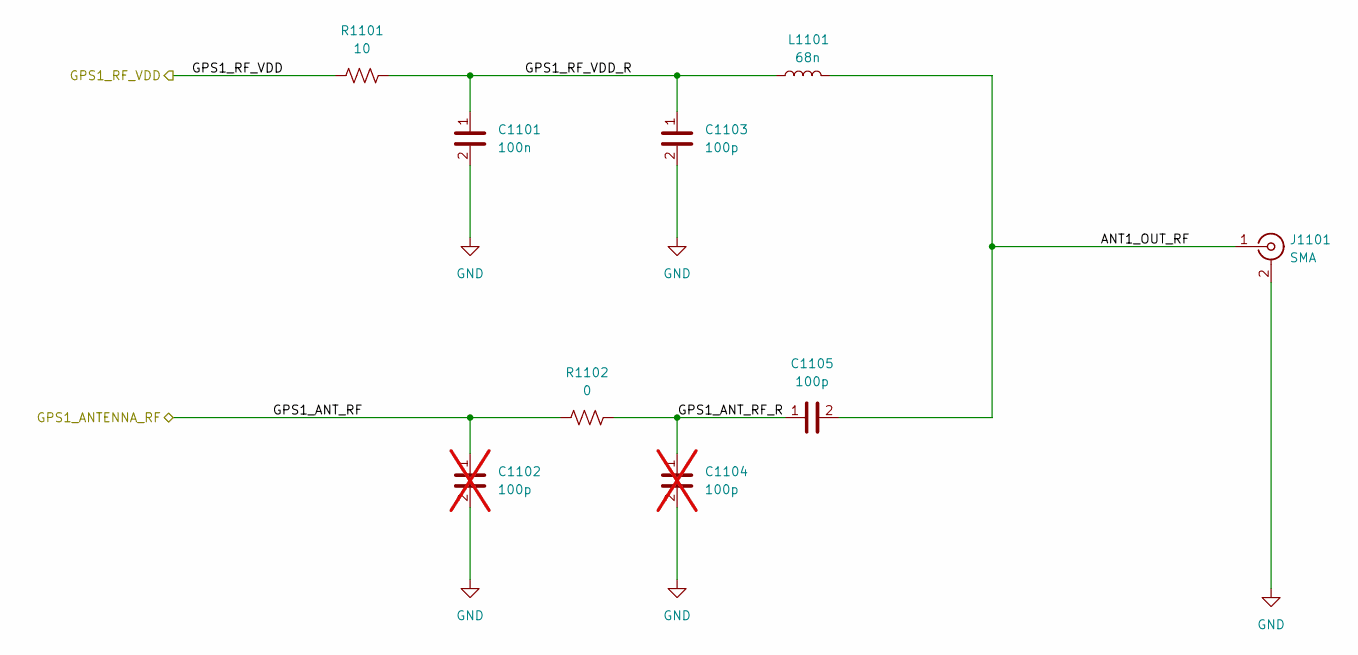
[picture p19: schematic Antenna1.kicad_sch]

Parts:
C1101: 100n; C_0402_1005Metric_Pad0.74x0.62mm_HandSolder; Manufacturer P/N CL05B104KB54PNC; LCSC P/N C307331
C1102, C1104: 100p; C_0402_1005Metric_Pad0.74x0.62mm_HandSolder; LCSC P/N C1546; not fitted
C1103, C1105: 100p; C_0402_1005Metric_Pad0.74x0.62mm_HandSolder; LCSC P/N C1546
J1101: SMA; THT SMA; Manufacturer P/N SMA-J-P-H-ST-TH1; Digikey P/N SAM8971-ND
L1101: 68n; L_0402_1005Metric_Pad0.77x0.64mm_HandSolder; Manufacturer P/N LQW15AN68NG0ZD; Digikey P/N 490-17700-2-ND
R1101: 10; R_0402_1005Metric_Pad0.72x0.64mm_HandSolder; Mouser P/N 708-RMCF0402FT10R0; Digikey P/N RMCF0402FT10R0CT-ND
R1102: 0; R_0402_1005Metric_Pad0.72x0.64mm_HandSolder; Mouser P/N 708-RMCF0402ZT0R00; Digikey P/N RMCF0402ZT0R00CT-ND

Connections:
/Antenna1/ANT1_OUT_RF: C1105.2, J1101.1, L1101.1
/Antenna1/GPS1_ANT_RF_R: C1104.1, C1105.1, R1102.2
/Antenna1/GPS1_RF_VDD: R1101.1; also elsewhere on the board
/Antenna1/GPS1_RF_VDD_R: C1101.1, C1103.1, L1101.2, R1101.2
/GPS1_ANTENNA_RF: C1102.1, R1102.1; also elsewhere on the board
GND: C1101.2, C1102.2, C1103.2, C1104.2, J1101.2; also elsewhere on the board

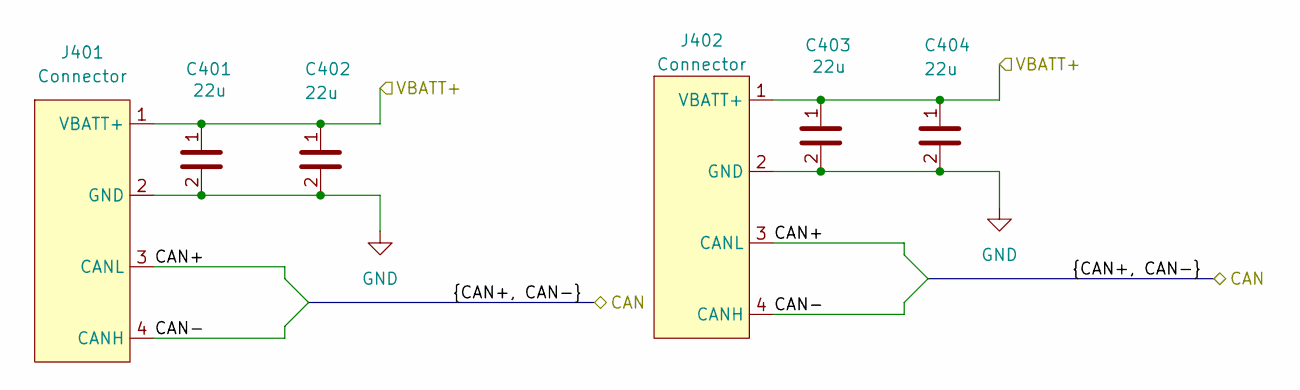
[picture p20: schematic main_io.kicad_sch]

Parts:
C401, C402, C403, C404: 22u; C_0805_2012Metric_Pad1.18x1.45mm_HandSolder; Mouser P/N 187-CL21A226MAYNNNE
J401, J402: Connector; Molex_Micro-Fit_3.0_43650-0400_1x04_P3.00mm_Horizontal; Manufacturer P/N 0436500401; Digikey P/N WM1867-ND

Connections:
/CAN+: J401.3 (CANL), J402.3 (CANL); also elsewhere on the board
/CAN-: J401.4 (CANH), J402.4 (CANH); also elsewhere on the board
/Main IO/VBATT+: C401.1, C402.1, C403.1, C404.1, J401.1 (VBATT+), J402.1 (VBATT+); also elsewhere on the board
GND: C401.2, C402.2, C403.2, C404.2, J401.2 (GND), J402.2 (GND); also elsewhere on the board

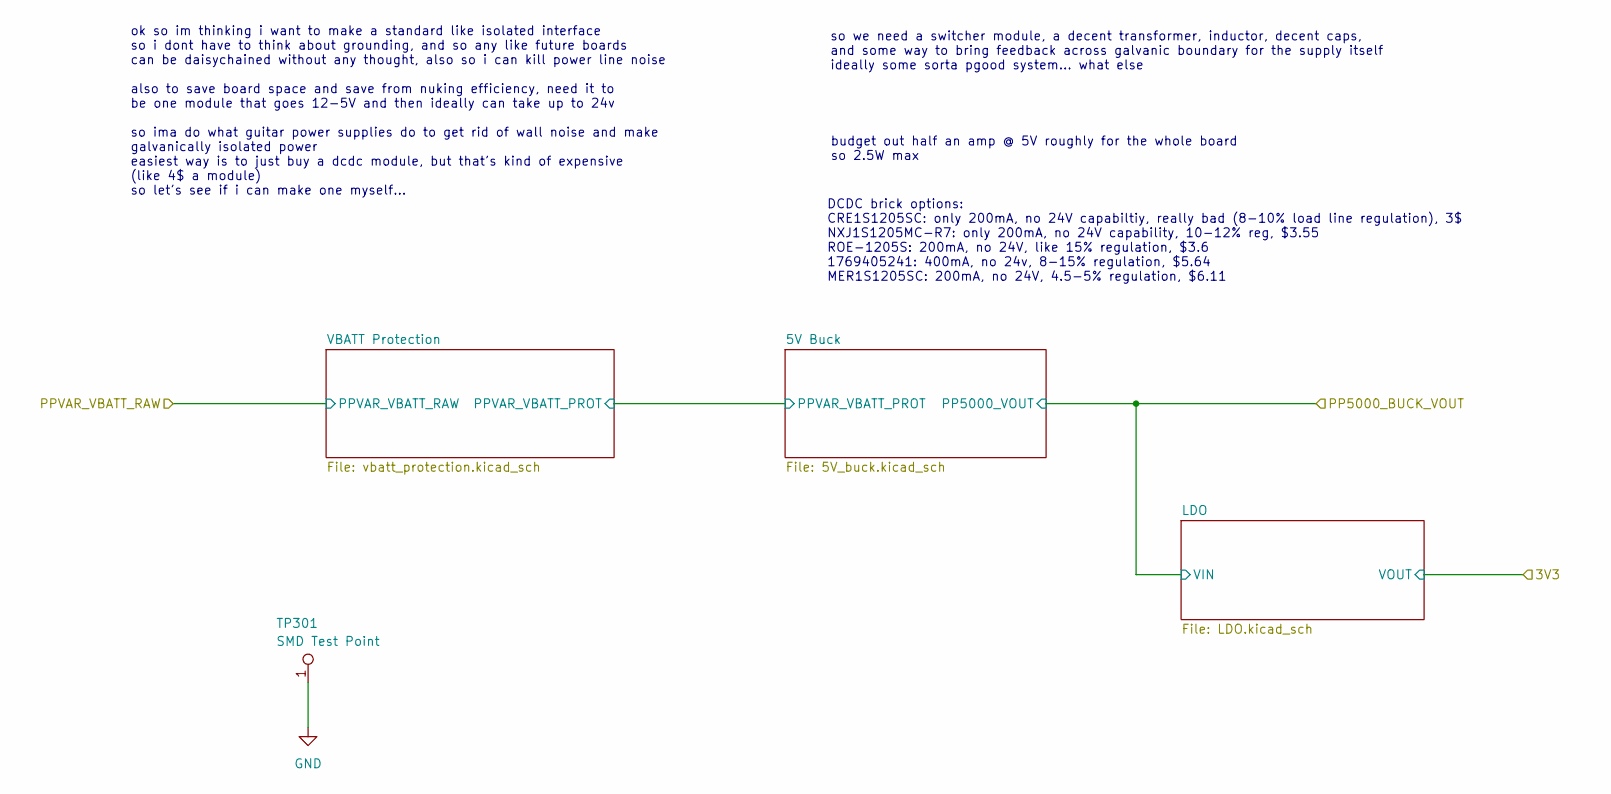
[picture p21: schematic power.kicad_sch]

Parts:
TP301: SMD Test Point; TestPoint_Keystone_5019_Miniature; Manufacturer P/N RH-5019; Digikey P/N 36-5019CT-ND

Connections:
GND: TP301.1; also elsewhere on the board

Notes on the sheet:
ok so im thinking i want to make a standard like isolated interface so i dont have to think about grounding, and so any like future boards can be daisychained without any thought, also so i can kill power line noise also to save board space and save from nuking efficiency, need it to be one module 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
so we need a switcher module, a decent transformer, inductor, decent caps, and some way to bring feedback across galvanic boundary for the supply itself ideally some sorta pgood system... what else
DCDC brick options: CRE1S1205SC: only 200mA, no 24V capabiltiy, really bad (8-10% load line regulation), 3$ NXJ1S1205MC-R7: only 200mA, no 24V capability, 10-12% reg, $3.55 ROE-1205S: 200mA, no 24V, like 15% regulation, $3.6 1769405241: 400mA, no 24v, 8-15% regulation, $5.64 MER1S1205SC: 200mA, no 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
budget out half an amp @ 5V roughly for the whole board so 2.5W max

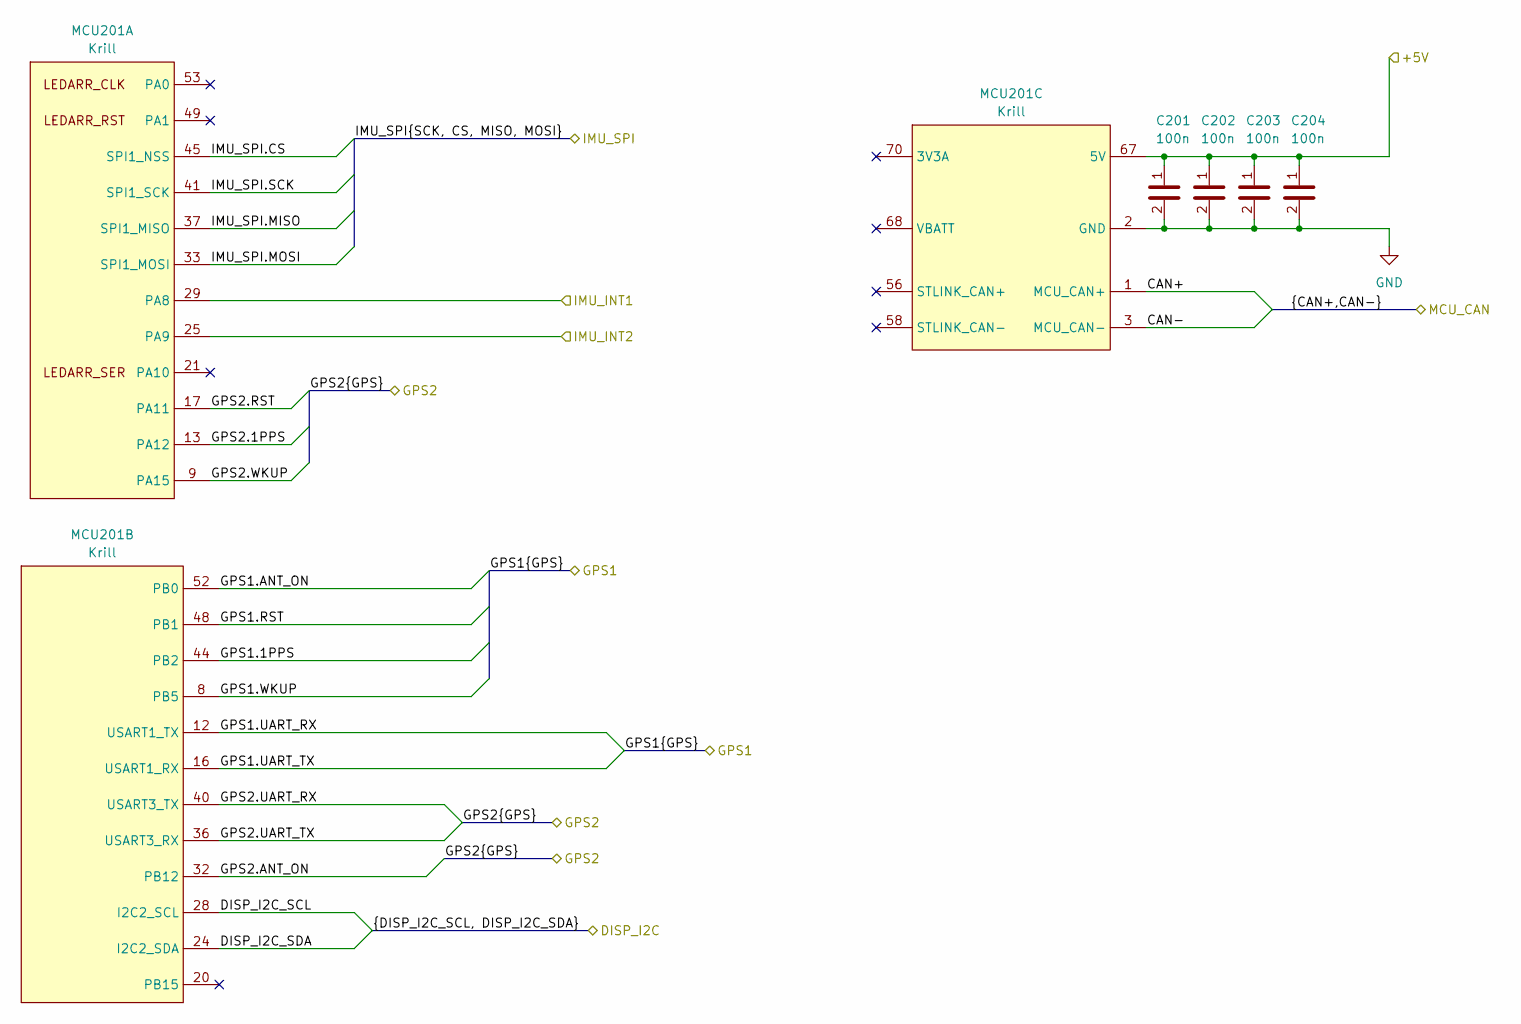
[picture p22: schematic Microcontroller.kicad_sch]

Parts:
C201, C202, C203, C204: 100n; C_0402_1005Metric_Pad0.74x0.62mm_HandSolder; LCSC P/N C1525
MCU201: Krill; Manufacturer P/N 2E0BC21-S85BM-7H; Digikey P/N 609-MDT850M01501CT-ND

Connections:
+5V: C201.1, C202.1, C203.1, C204.1, MCU201.67 (5V), MCU201.69 (5V), MCU201.71 (5V); also elsewhere on the board
/CAN+: MCU201.1 (MCU_CAN+); also elsewhere on the board
/CAN-: MCU201.3 (MCU_CAN-); also elsewhere on the board
/GPS1.1PPS: MCU201.44 (PB2); also elsewhere on the board
/GPS1.ANT_ON: MCU201.52 (PB0); also elsewhere on the board
/GPS1.RST: MCU201.48 (PB1); also elsewhere on the board
/GPS1.UART_RX: MCU201.12 (USART1_TX); also elsewhere on the board
/GPS1.WKUP: MCU201.8 (PB5); also elsewhere on the board
/GPS2.1PPS: MCU201.13 (PA12); also elsewhere on the board
/GPS2.ANT_ON: MCU201.32 (PB12); also elsewhere on the board
/GPS2.RST: MCU201.17 (PA11); also elsewhere on the board
/GPS2.UART_RX: MCU201.16 (USART1_RX), MCU201.40 (USART3_TX); also elsewhere on the board
/GPS2.UART_TX: MCU201.36 (USART3_RX); also elsewhere on the board
/GPS2.WKUP: MCU201.9 (PA15); also elsewhere on the board
/IMU/IMU_INT1: MCU201.29 (PA8); also elsewhere on the board
/IMU/IMU_INT2: MCU201.25 (PA9); also elsewhere on the board
/IMU_SPI.CS: MCU201.45 (SPI1_NSS); also elsewhere on the board
/IMU_SPI.MISO: MCU201.37 (SPI1_MISO); also elsewhere on the board
/IMU_SPI.MOSI: MCU201.33 (SPI1_MOSI); also elsewhere on the board
/IMU_SPI.SCK: MCU201.41 (SPI1_SCK); also elsewhere on the board
/Microcontroller/DISP_I2C_SCL: MCU201.28 (I2C2_SCL)
/Microcontroller/DISP_I2C_SDA: MCU201.24 (I2C2_SDA)
GND: C201.2, C202.2, C203.2, C204.2, MCU201.2 (GND), MCU201.4 (GND), MCU201.5 (GND), MCU201.6 (GND), MCU201.7 (GND), MCU201.10 (GND), MCU201.11 (GND), MCU201.14 (GND), MCU201.15 (GND), MCU201.18 (GND), MCU201.19 (GND), MCU201.22 (GND), MCU201.23 (GND), MCU201.26 (GND), MCU201.27 (GND), MCU201.30 (GND), MCU201.31 (GND), MCU201.34 (GND), MCU201.35 (GND), MCU201.38 (GND), MCU201.39 (GND), MCU201.42 (GND), MCU201.43 (GND), MCU201.46 (GND), MCU201.47 (GND), MCU201.50 (GND), MCU201.51 (GND), MCU201.54 (GND), MCU201.55 (GND), MCU201.57 (GND), MCU201.73 (GND), MCU201.75 (GND); also elsewhere on the board

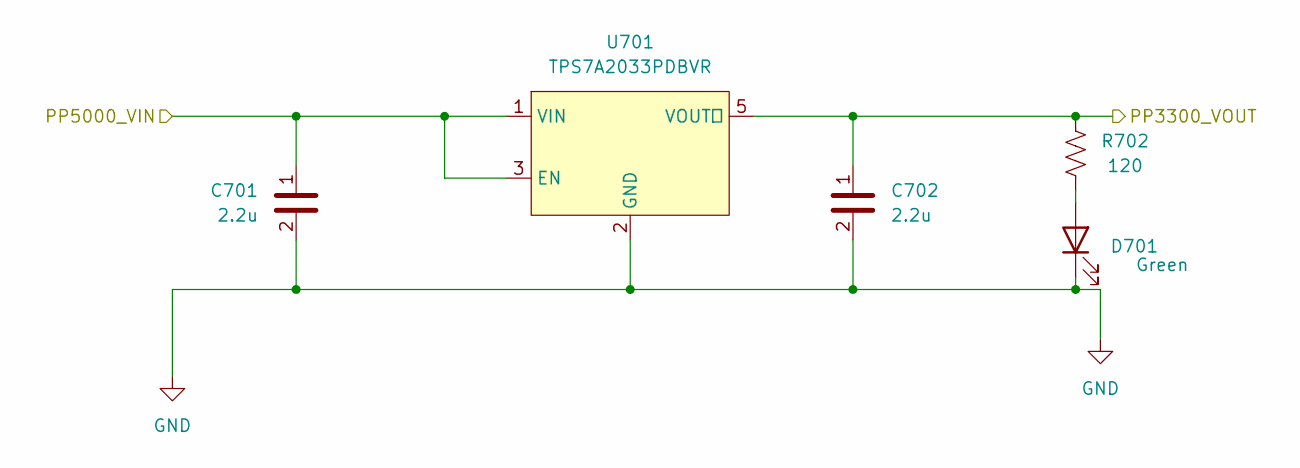
[picture p23: schematic low_noise_ldo.kicad_sch]

Parts:
C701, C702: 2.2u; C_0402_1005Metric_Pad0.74x0.62mm_HandSolder; LCSC P/N C12530
D701: Green; D_0805_2012Metric_Pad1.15x1.40mm_HandSolder; Mouser P/N 755-SMLMN2ECTT86C; Digikey P/N 846-SMLMN2ECTT86CCT-ND
R702: 120; R_0603_1608Metric_Pad0.98x0.95mm_HandSolder; Mouser P/N 708-RMCF0603FT120R; Digikey P/N RMCF0603FT120RCT-ND
U701: TPS7A2033PDBVR; SOT-23-5_HandSoldering; Manufacturer P/N TPS7A2033PDBVR; Digikey P/N 296-TPS7A2033PDBVRCT-ND

Connections:
+5V: C701.1, U701.1 (VIN), U701.3 (EN); also elsewhere on the board
/GPS/PP3300_GPS1_VCC: C702.1, R702.1, U701.5 (VOUT); also elsewhere on the board
GND: C701.2, C702.2, D701.1 (K), U701.2 (GND); also elsewhere on the board
unnamed: D701.2 (A), R702.2

Parts of its further copies:
C801, C802, C901, C902: 2.2u; C_0402_1005Metric_Pad0.74x0.62mm_HandSolder; LCSC P/N C12530
D801, D901: Green; D_0805_2012Metric_Pad1.15x1.40mm_HandSolder; Mouser P/N 755-SMLMN2ECTT86C; Digikey P/N 846-SMLMN2ECTT86CCT-ND
R802, R902: 120; R_0603_1608Metric_Pad0.98x0.95mm_HandSolder; Mouser P/N 708-RMCF0603FT120R; Digikey P/N RMCF0603FT120RCT-ND
U801, U901: TPS7A2033PDBVR; SOT-23-5_HandSoldering; Manufacturer P/N TPS7A2033PDBVR; Digikey P/N 296-TPS7A2033PDBVRCT-ND

Connections of its further copies:
+5V: C801.1, C901.1, U801.1 (VIN), U801.3 (EN), U901.1 (VIN), U901.3 (EN); also elsewhere on the board
/GPS/PP3300_GPS2_VCC: C802.1, R802.1, U801.5 (VOUT); also elsewhere on the board
/IMU/PP3300_IMU_VDD: C902.1, R902.1, U901.5 (VOUT); also elsewhere on the board
GND: C801.2, C802.2, C901.2, C902.2, D801.1 (K), D901.1 (K), U801.2 (GND), U901.2 (GND); also elsewhere on the board
unnamed: D801.2 (A), R802.2
unnamed: D901.2 (A), R902.2
