bruinformula/mk11-DAQ-SMU/SMU V2/SMU V2.kicad_pcb

## KiCad design SMU V2/SMU V2.kicad_pcb (continued)

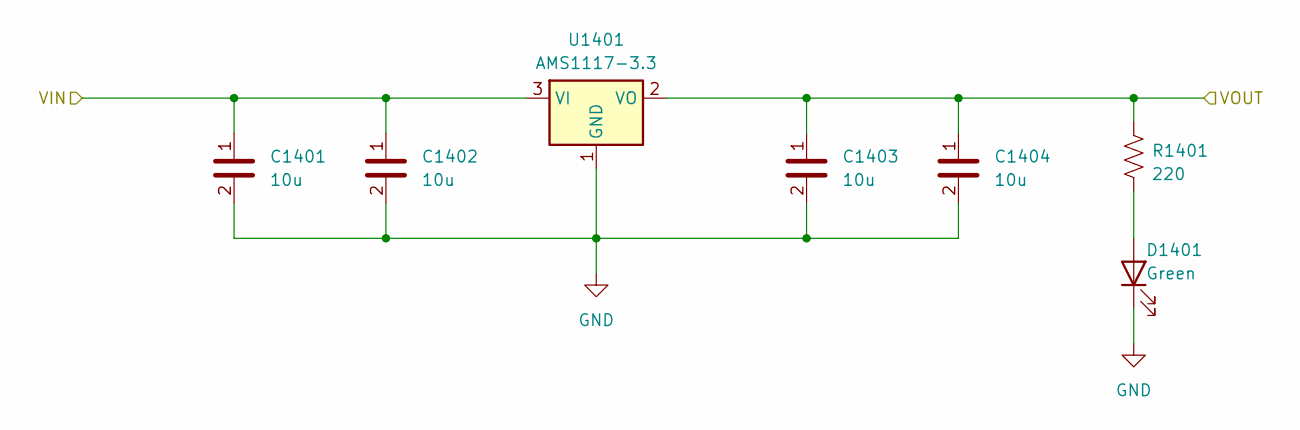
[picture p24: schematic LDO.kicad_sch]

Parts:
C1401, C1402, C1403, C1404: 10u; C_0603_1608Metric_Pad1.08x0.95mm_HandSolder; Mouser P/N 81-GRM188R61E106MA3D
D1401: Green; D_0805_2012Metric_Pad1.15x1.40mm_HandSolder; Mouser P/N 755-SMLMN2ECTT86C; Digikey P/N 846-SMLMN2ECTT86CCT-ND
R1401: 220; R_0402_1005Metric_Pad0.72x0.64mm_HandSolder; Mouser P/N 708-RMCF0402FT220R; Digikey P/N RMCF0402FT220RCT-ND
U1401: AMS1117-3.3; SOT-223-3_TabPin2; Mouser P/N 637-LDI1117-3.3H; Digikey P/N 5272-AMS1117-3.3CT-ND

Connections:
+3V3: C1403.1, C1404.1, R1401.2, U1401.2 (VO)
+5V: C1401.1, C1402.1, U1401.3 (VI); also elsewhere on the board
GND: C1401.2, C1402.2, C1403.2, C1404.2, D1401.1 (K), U1401.1 (GND); also elsewhere on the board
unnamed: D1401.2 (A), R1401.1

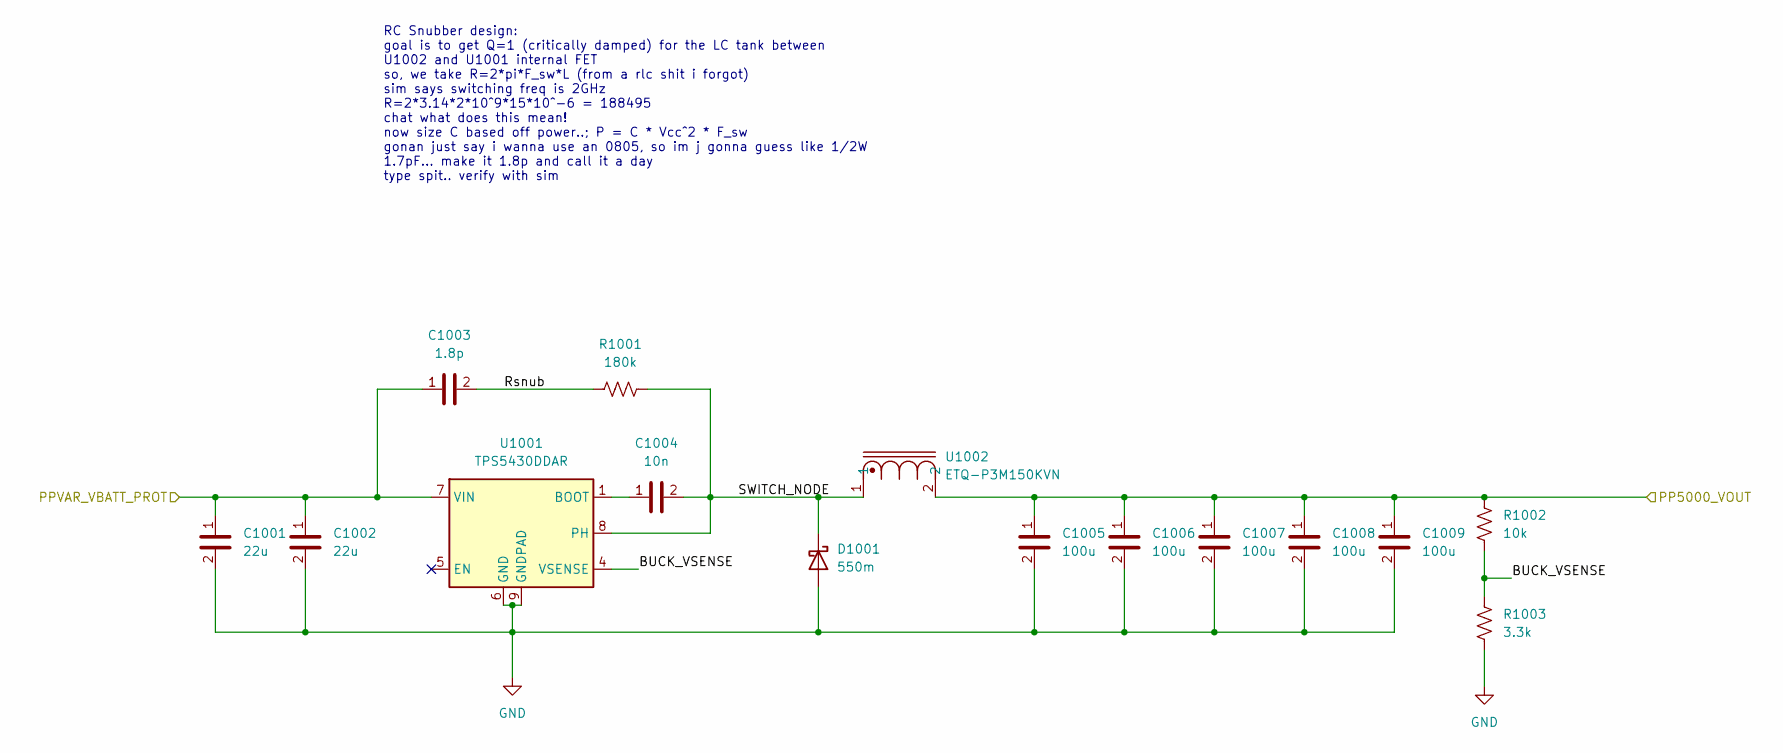
[picture p25: schematic 5V_buck.kicad_sch]

Parts:
C1001, C1002: 22u; C_0603_1608Metric_Pad1.08x0.95mm_HandSolder; LCSC P/N C59461
C1003: 1.8p; C_0805_2012Metric_Pad1.18x1.45mm_HandSolder; Mouser P/N 581-600F1R8BT; Digikey P/N 1284-1034-1-ND
C1004: 10n; C_0603_1608Metric_Pad1.08x0.95mm_HandSolder; Mouser P/N 77-VJ0603Y103KXAAC; Digikey P/N 720-1376-1-ND
C1005, C1006, C1007, C1008, C1009: 100u; C_1206_3216Metric_Pad1.33x1.80mm_HandSolder; LCSC P/N C15008
D1001: 550m; D_SMA_Handsoldering; Mouser P/N 750-SS54-HF; LCSC P/N C22452
R1001: 180k; R_0805_2012Metric_Pad1.20x1.40mm_HandSolder; Mouser P/N 708-RMCF0805FT180K; Digikey P/N RMCF0805FT180KCT-ND
R1002: 10k; R_0402_1005Metric_Pad0.72x0.64mm_HandSolder; Mouser P/N 708-RMCF0402FT10K0; Digikey P/N RMCF0402FT10K0CT-ND
R1003: 3.3k; R_0402_1005Metric_Pad0.72x0.64mm_HandSolder; Mouser P/N 708-RMCF0402FT3K30; Digikey P/N RMCF0402FT3K30CT-ND
U1001: TPS5430DDAR; TI_SO-PowerPAD-8; Mouser P/N 595-TPS5430DDAR; Digikey P/N 296-26988-1-ND
U1002: ETQ-P3M150KVN; BWVS005050404R7M00; Manufacturer P/N ETQ-P3M150KVN; Digikey P/N P19763CT-ND

Connections:
+5V: C1005.1, C1006.1, C1007.1, C1008.1, C1009.1, R1002.2, U1002.2; also elsewhere on the board
/Power/5V Buck/BUCK_VSENSE: R1002.1, R1003.2, U1001.4 (VSENSE)
/Power/5V Buck/PPVAR_VBATT_PROT: C1001.1, C1002.1, C1003.1, U1001.7 (VIN); also elsewhere on the board
/Power/5V Buck/Rsnub: C1003.2, R1001.1
/Power/5V Buck/SWITCH_NODE: C1004.2, D1001.1 (K), R1001.2, U1001.8 (PH), U1002.1
GND: C1001.2, C1002.2, C1005.2, C1006.2, C1007.2, C1008.2, C1009.2, D1001.2 (A), R1003.1, U1001.6 (GND), U1001.9 (GNDPAD); also elsewhere on the board
unnamed: C1004.1, U1001.1 (BOOT)

Notes on the sheet:
RC Snubber design: goal is to get Q=1 (critically damped) for the LC tank between U1002 and U1001 internal FET so, we take R=2*pi*F_sw*L (from a rlc shit i forgot) sim says switching freq is 2GHz R=2*3.14*2*10^9*15*10^-6 = 188495 chat what does this mean! now size C based off power..; P = C * Vcc^2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

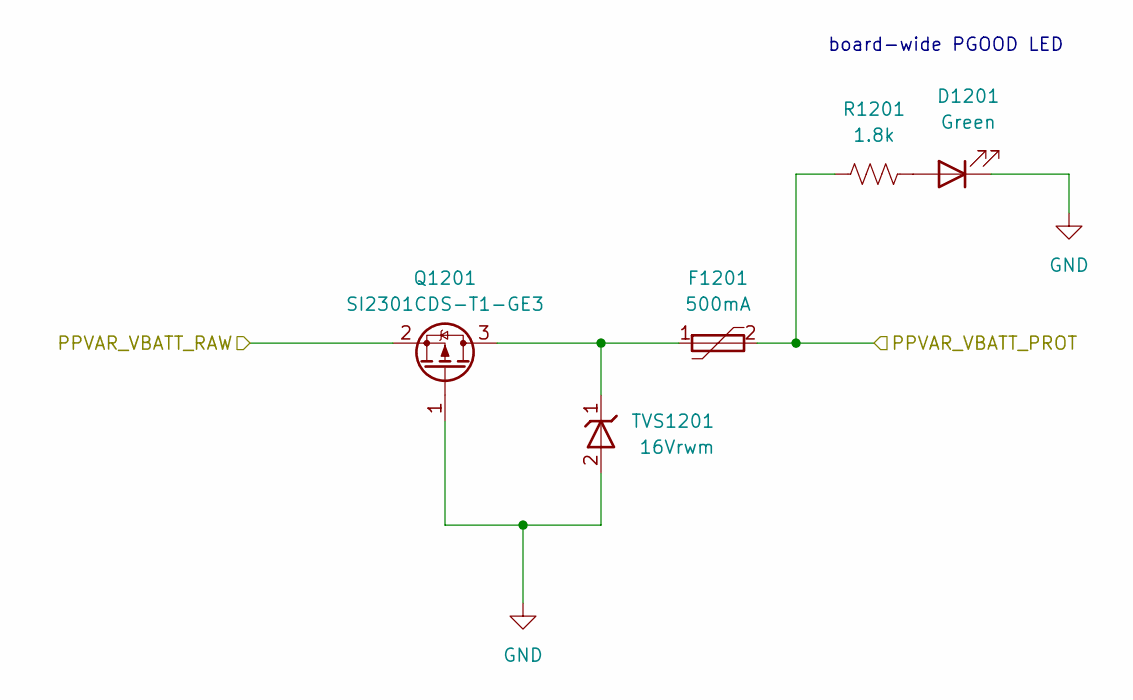
[picture p26: schematic vbatt_protection.kicad_sch]

Parts:
D1201: Green; D_0805_2012Metric_Pad1.15x1.40mm_HandSolder; Mouser P/N 755-SMLMN2ECTT86C; Digikey P/N 846-SMLMN2ECTT86CCT-ND
F1201: 500mA; Fuse_1812_4532Metric; Manufacturer P/N 0ZCG0050AF2C; Digikey P/N 5923-0ZCG0050AF2CCT-ND
Q1201: SI2301CDS-T1-GE3; SOT-23-3; Mouser P/N 781-SI2301CDS-T1-GE3; LCSC P/N C10487
R1201: 1.8k; R_0603_1608Metric_Pad0.98x0.95mm_HandSolder; Mouser P/N 708-RMCF0603FT1K80; Digikey P/N RMCF0603FT1K80CT-ND
TVS1201: 16Vrwm; D_SMA-SMB_Universal_Handsoldering; Manufacturer P/N SMBJ16A; Digikey P/N SMBJ16ABCT-ND

Connections:
/Main IO/VBATT+: Q1201.2 (S); also elsewhere on the board
/Power/5V Buck/PPVAR_VBATT_PROT: F1201.2, R1201.1; also elsewhere on the board
GND: D1201.1 (K), Q1201.1 (G), TVS1201.2; also elsewhere on the board
unnamed: D1201.2 (A), R1201.2
unnamed: F1201.1, Q1201.3 (D), TVS1201.1

Notes on the sheet:
board-wide PGOOD LED

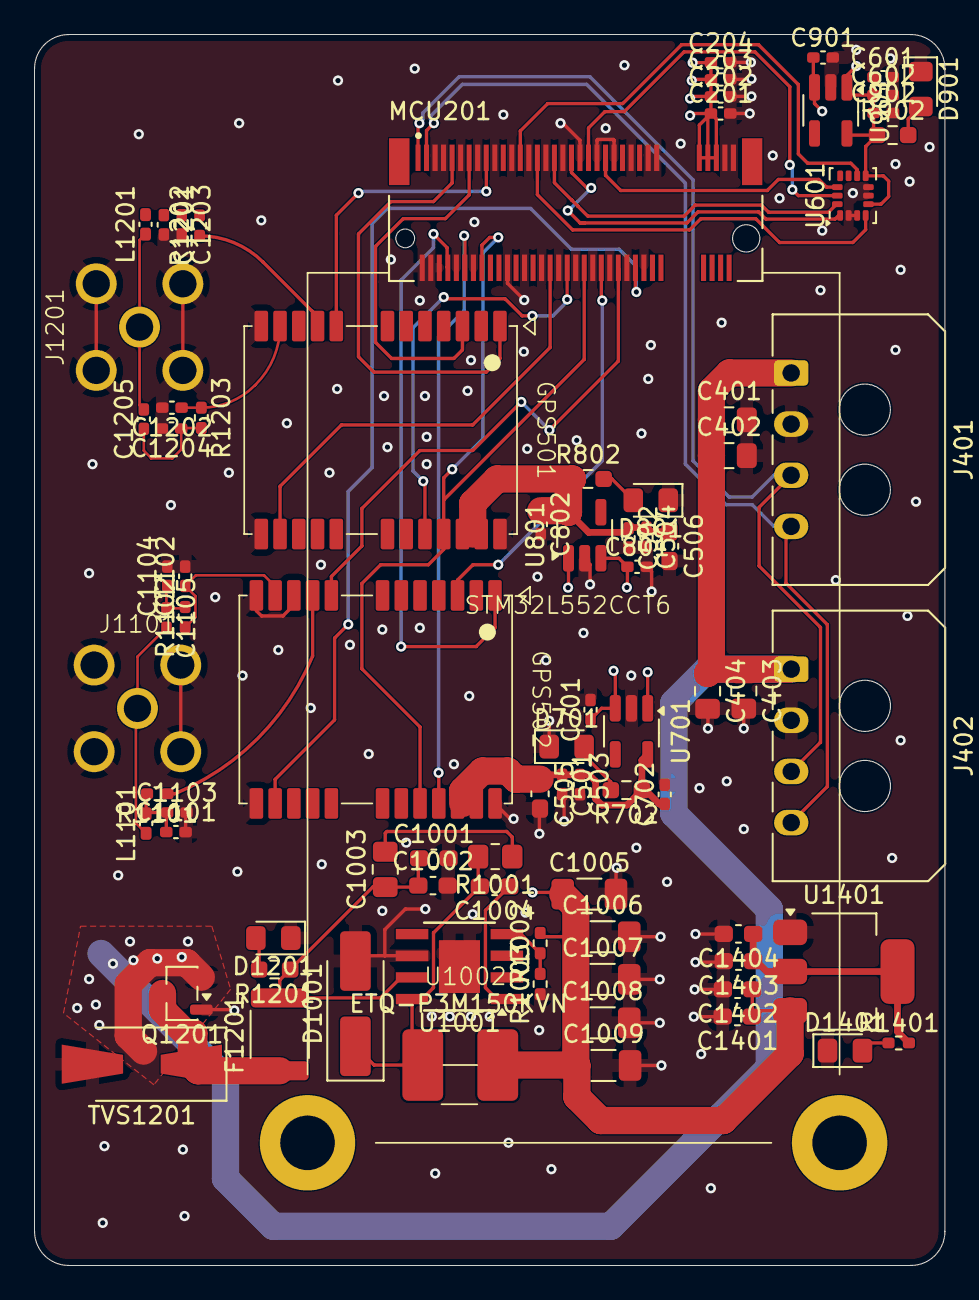
[picture p27: board SMU V2.kicad_pcb from above]

Board: 4 copper layers, 53.4 x 72.2 mm, 83 parts (1 on the bottom side), 47 nets.
