bruinformula/mk11-DAQ-SMU/(commit log)

2025-12-24 i forget what i changed
    [5V_buck.kicad_sch, 5v_flyback.kicad_sch, Microcontroller.kicad_sch, SMU V1.kicad_pcb, SMU V1.kicad_sch, diagnostic.kicad_sch, gps.kicad_sch, gps_power.kicad_sch]
2026-01-14 halfway done with routing, still needs antenna
    [5V_buck.kicad_sch, Microcontroller.kicad_sch, SMU V1.kicad_pcb, SMU V1.kicad_sch, gps.kicad_sch, imu.kicad_sch, low_noise_ldo.kicad_sch, main_io.kicad_sch]
2026-01-15 finished, should prob double check the high frequency stuff
    [Microcontroller.kicad_sch, SMU V1.kicad_pcb, SMU V1.kicad_sch, antenna.kicad_sch, gps.kicad_sch, low_noise_ldo.kicad_sch, vbatt_protection.kicad_sch]
2026-04-22 v2 layout
    [5V_buck.kicad_sch, Antenna1.kicad_sch, Antenna2.kicad_sch, Display.kicad_sch, LDO.kicad_sch, Microcontroller.kicad_sch, SMU V1.kicad_pcb, SMU V2.kicad_pcb]
2026-05-11 improved V3
    added uart/spi test points and status leds
    removed main 3v3 ldo
    added silkscreen
    [5V_buck.kicad_sch, Antenna1.kicad_sch, Antenna2.kicad_sch, Display.kicad_sch, Microcontroller.kicad_sch, SMU V3.kicad_pcb, SMU V3.kicad_sch, gps.kicad_sch]
2026-05-11 fixed mounting holes
    [SMU V3.kicad_pcb]
2026-05-11 actual final v3
    [SMU V3-B_Cu.gbr, SMU V3-B_Mask.gbr, SMU V3-B_Paste.gbr, SMU V3-B_Silkscreen.gbr, SMU V3-Edge_Cuts.gbr, SMU V3-F_Cu.gbr, SMU V3-F_Mask.gbr, SMU V3-F_Paste.gbr]
